fx-tronik/svs-controller/components/DMX.xlsx

Qty | Value | Device | Package | Parts | Description | MF | MPN | link | zamiennik
1 |  | PINHD-1X8/90 | 1X08/90 | JP1 | PIN HEADER | CONNFLY | DS1022-1*20RDF1-1 | https://www.tme.eu/pl/details/zl211-20kg/listwy-i-gniazda-kolkowe/connfly/ds1022-1_20rdf1-1/
3 | 0.1UF | C-EUC0603 | C0603 | C1, C4, C7 | CAPACITOR, European symbol | AVX | 06033C104KAT2A | https://pl.mouser.com/ProductDetail/AVX/06033C104KAT2A?qs=sGAEpiMZZMs0AnBnWHyRQNmRHsAguE21wvjfH6R99Ys%3d | https://pl.mouser.com/ProductDetail/KEMET/C0603C104K4RAC7411
2 | 10UF | C-EUC0805 | C0805 | C3, C6 | CAPACITOR, European symbol | AVX | 08056G106ZAT2A | https://pl.mouser.com/ProductDetail/AVX/08056G106ZAT2A
2 | 10k | R-EU_R0603 | R0603 | R1, R2 | RESISTOR, European symbol | Yageo | RC0603JR-0710KA | https://pl.mouser.com/ProductDetail/Yageo/RC0603JR-0710KA
1 | 120 | R-EU_R0603 | R0603 | R5 | RESISTOR, European symbol | Yageo | RC0603FR-10120RL | https://pl.mouser.com/ProductDetail/Yageo/RC0603FR-10120RL
3 | 1UF | C-EUC0603 | C0603 | C2, C5, C8 | CAPACITOR, European symbol | AVX | 0603YC105KAT4A | https://pl.mouser.com/ProductDetail/AVX/0603YC105KAT4A | https://pl.mouser.com/ProductDetail/AVX/0603ZG105ZAT2A
2 | 560 | R-EU_R0603 | R0603 | R3, R4 | RESISTOR, European symbol | Yageo | RC0603FR-13560RL | https://pl.mouser.com/ProductDetail/Yageo/RC0603FR-13560RL
1 | BAT54C | BAT54C | SOT23 | D1 | Schottky Diodes | ROHM Semiconductor | 755-BAT54AHMFHT116 | https://pl.mouser.com/ProductDetail/ROHM-Semiconductor/BAT54AHMFHT116
1 | MAX14946 | MAX14946 | SOIC16W | U$1 | Isolated 500kbps Half-Duplex | Maxim | 700-MAX14946EWE+ | https://pl.mouser.com/ProductDetail/Maxim-Integrated/MAX14946EWE%2b
1 | NC5FAH | NC5FAH | NC5FAH | X2 | Neutrik Audio Connector XLR SERIES | Neutrik | NC5FAH | https://pl.mouser.com/ProductDetail/Neutrik/NC5FAH
1 | SWS003 | SWS003 | SMS-003 | S1 | SMD Dip Switch 3 pol. | CTS Electronic Components | 774-2193MST | https://pl.mouser.com/ProductDetail/CTS-Electronic-Components/219-3MST
1 | WURTH_TRANSFORMER_750315227 | WURTH_TRANSFORMER_750315227 | WURTH750315227 | U$2 |  | Wurth Electronics | 710-750315227 | https://pl.mouser.com/ProductDetail/Wurth-Electronics/750315227
