fx-tronik/svs-controller/components/MCU.xlsx

Qty | Value | Device | Package | Parts | Description | MF | MPN | link | zamiennik | w innej konfiguracji | komentarz
16 |  | LEDCHIP-LED0603 | CHIP-LED0603 | LED1, LED2, LED3, LED4, LED5, LED6, LED7, LED8, LED12, LED13, LED14, LED15, LED16, LED17, LED18, LED19 | LED | Kingbright | APTD1608LCGCK | https://pl.mouser.com/ProductDetail/Kingbright/APTD1608LCGCK
2 |  | LEDCHIP-LED0603 | CHIP-LED0603 | LED9, LED10 | LED | Kingbright | APTD1608LSURCK | https://pl.mouser.com/ProductDetail/Kingbright/APTD1608LSURCK
1 |  | ML10 | ML10 | SV1 | HARTING | Wurth Electronics | 61201021621 | https://pl.mouser.com/ProductDetail/Wurth-Electronics/61201021621
1 |  | PINHD-1X2 | 1X02 | JP3 | PIN HEADER | NINIGI | ZL2019-40 | nie potrzeba, jest na magazynie
1 |  | PINHD-2X12 | 2X12 | JP2 | PIN HEADER | NINIGI | ZL2019-40 | https://www.tme.eu/pl/details/zl2019-2x20/listwy-i-gniazda-kolkowe/ninigi/zl2019-40/
1 |  | PINHD-2X6 | 2X06 | JP1 | PIN HEADER | NINIGI | ZL2019-40 | JP1 oraz JP2 z jednej złączki
1 |  | STM32F429ZILQFP144 | LQFP144 | IC2 |  | STMicroelectronics | STM32F429ZIT6 | https://pl.mouser.com/ProductDetail/STMicroelectronics/STM32F429ZIT6?qs=sGAEpiMZZMvh0aGzCjJ9puxTF1TQ%2fe28
2 | 0,22uF | C-EUC0603 | C0603 | C48, C51 | CAPACITOR, European symbol | AVX | 0603ZC224KAT9A | https://pl.mouser.com/ProductDetail/AVX/0603ZC224KAT9A
5 | 0R | R-EU_R0603 | R0603 | R41, R42, R43, R44, R45 | RESISTOR, European symbol | Yageo | RC0603JR-070RL | https://pl.mouser.com/ProductDetail/Yageo/RC0603JR-070RL | https://pl.mouser.com/ProductDetail/Yageo/AC0603JR-130RL
20 | 1.2k | R-EU_R0603 | R0603 | R17, R18, R19, R20, R21, R22, R23, R24, R25, R27, R28, R29, R54, R55, R56, R57, R58, R59, R60, R61 | RESISTOR, European symbol | Yageo | RC0603FR-071K2L | https://pl.mouser.com/ProductDetail/Yageo/RC0603FR-071K2L?qs=sGAEpiMZZMu61qfTUdNhG5eFuApKbqVdGHoRw3xWRI8%3d | https://pl.mouser.com/ProductDetail/Yageo/RC0603FR-131K2L?qs=sGAEpiMZZMu61qfTUdNhG6gKAQVNBKOo4NYn0ZHNCDU%3d
12 | 100nF | C-EUC0603 | C0603 | C33, C34, C35, C37, C38, C39, C40, C41, C42, C43, C46, C47 | CAPACITOR, European symbol | AVX | 06033C104KAT2A | https://pl.mouser.com/ProductDetail/AVX/06033C104KAT2A?qs=sGAEpiMZZMs0AnBnWHyRQNmRHsAguE21wvjfH6R99Ys%3d | https://pl.mouser.com/ProductDetail/KEMET/C0603C104K4RAC7411
15 | 100nF | C-EUC0603K | C0603K | C9, C16, C17, C18, C19, C20, C21, C22, C23, C24, C26, C28, C29, C31, C32 | CAPACITOR, European symbol | AVX | 06033C104KAT2A | to samo co wyżej
2 | 10pF | C-EUC0603K | C0603K | C11, C12 | CAPACITOR, European symbol | AVX | 06035A100JAT2A | https://pl.mouser.com/ProductDetail/AVX/06035A100JAT2A | https://pl.mouser.com/ProductDetail/AVX/06035A100K4T4A
1 | 10uF | CPOL-EUSMCA | SMC_A | C36 | POLARIZED CAPACITOR, European symbol | AVX | F931A106MAA | https://pl.mouser.com/ProductDetail/AVX/F931A106MAA?qs=sGAEpiMZZMuEN2agSAc2puC4lhRhLeoldocdITijc4A%3d
2 | 10uF/6,3V | C-EUC1206 | C1206 | C50, C53 | CAPACITOR, European symbol | AVX | 12066G106ZAT4A | https://pl.mouser.com/ProductDetail/AVX/12066G106ZAT4A
2 | 110R | R-EU_R0603 | R0603 | R50, R52 | RESISTOR, European symbol | Yageo | RC0603FR-07110RL | https://pl.mouser.com/ProductDetail/Yageo/RC0603FR-07110RL?qs=sGAEpiMZZMu61qfTUdNhG0fejjHH2KXSKTcPaQ6ifbY%3d
2 | 191k | R-EU_R0603 | R0603 | R111, R115 | RESISTOR, European symbol | Yageo | AC0603FR-07191KL | https://pl.mouser.com/ProductDetail/Yageo/AC0603FR-07191KL
1 | 1K5 | R-EU_R0603 | R0603 | R31 | RESISTOR, European symbol | Yageo | RC0603FR-071K5P | https://pl.mouser.com/ProductDetail/Yageo/RC0603FR-071K5P
2 | 1nF, 2kV | C-EUC1206 | C1206 | C44, C45 | CAPACITOR, European symbol | Vishay | VJ1206Y102MXFAT4X | https://pl.mouser.com/ProductDetail/Vishay-Vitramon/VJ1206Y102MXFAT4X
2 | 1uF | C-EUC0603K | C0603K | C10, C30 | CAPACITOR, European symbol | AVX | 0603YC105KAT4A | https://pl.mouser.com/ProductDetail/AVX/0603YC105KAT4A | https://pl.mouser.com/ProductDetail/AVX/0603ZG105ZAT2A
2 | 1uF/50V | C-EUC1206 | C1206 | C49, C52 | CAPACITOR, European symbol | AVX | 12065C105M4Z2A | https://pl.mouser.com/ProductDetail/AVX/12065C105M4Z2A
8 | 2.2nF | C-EUC0805 | C0805 | C1, C2, C3, C4, C5, C6, C7, C8 | CAPACITOR, European symbol | AVX | 06035C222JAT2A | https://pl.mouser.com/ProductDetail/AVX/06035C222JAT2A
2 | 2.2uF | C-EUC0603K | C0603K | C25, C27 | CAPACITOR, European symbol | AVX | 06036C225KAT2A | https://pl.mouser.com/ProductDetail/AVX/06036C225KAT2A | https://pl.mouser.com/ProductDetail/AVX/06036G225ZAT2A
8 | 2.4k | R-EU_R1206 | R1206 | R9, R10, R11, R12, R13, R14, R15, R16 | RESISTOR, European symbol | Yageo | RC1206JR-072K4L | https://pl.mouser.com/ProductDetail/Yageo/RC1206JR-072K4L
8 | 210R | R-EU_R0603 | R0603 | R87, R88, R89, R90, R95, R96, R97, R98 | RESISTOR, European symbol | Bourns | CR0603-FX-2100ELF | https://pl.mouser.com/ProductDetail/Bourns/CR0603-FX-2100ELF
2 | 220uH | SRR4528A221M | SRR4528A | L2, L3 | SRR4528A | Bourns | SRR4528A-221M | https://pl.mouser.com/ProductDetail/Bourns/SRR4528A-221M
3 | 22k1 | R-EU_R0603 | R0603 | R26, R112, R116 | RESISTOR, European symbol | Yageo | AC0603FR-0722K1L | https://pl.mouser.com/ProductDetail/Yageo/AC0603FR-0722K1L
2 | 22pF | C-EUC0603K | C0603K | C13, C14 | CAPACITOR, European symbol | AVX | 06035A220JAT2A | https://pl.mouser.com/ProductDetail/AVX/06035A220JAT2A | https://pl.mouser.com/ProductDetail/AVX/06033A220JAT2A | https://pl.mouser.com/ProductDetail/AVX/0603YA270KAT2A?qs=sGAEpiMZZMs0AnBnWHyRQKdiqyDPVQdA8KETn2weImg%3d | musi współgrać z Q2 - CRYSTAL został zmieniony, możliwe, że wymagać będzie to także zmiany kondensatorów
2 | 261k | R-EU_R0603 | R0603 | R113, R117 | RESISTOR, European symbol | Bourns | CR0603-FX-2613ELF | https://pl.mouser.com/ProductDetail/Bourns/CR0603-FX-2613ELF
7 | 2K2 | R-EU_R0603 | R0603 | R30, R32, R33, R35, R36, R51, R53 | RESISTOR, European symbol | Yageo | RC0603FR-072K2P | https://pl.mouser.com/ProductDetail/Yageo/RC0603FR-072K2P
8 | 2k7 | R-EU_R0603 | R0603 | R91, R92, R93, R94, R99, R100, R101, R102 | RESISTOR, European symbol | Yageo | RC0603JR-072K7L | https://pl.mouser.com/ProductDetail/Yageo/RC0603JR-072K7L?qs=sGAEpiMZZMu61qfTUdNhG5eFuApKbqVdG3WnDY66KrI%3d
8 | 300R | R-EU_R0603 | R0603 | R79, R80, R81, R82, R103, R104, R105, R106 | RESISTOR, European symbol | Yageo | AC0603FR-07300RL | https://pl.mouser.com/ProductDetail/Yageo/AC0603FR-07300RL
1 | 32.768kHz | CRYSTAL3.5X1.5 | CRYSTAL_3.5X1.5 | Q1 | CRYSTAL | ECS | ECS-.327-9-34QCS-TR | https://pl.mouser.com/ProductDetail/ECS/ECS-327-9-34QCS-TR
17 | 33R | R-EU_R0603 | R0603 | R62, R63, R64, R65, R66, R67, R68, R69, R70, R71, R72, R73, R74, R75, R76, R77, R78 | RESISTOR, European symbol | Yageo | RC0603FR-071K2L | https://pl.mouser.com/ProductDetail/Yageo/RC0603FR-131K2L?qs=sGAEpiMZZMu61qfTUdNhG6gKAQVNBKOo4NYn0ZHNCDU%3d
1 | 4.7uF | C-EUC0603K | C0603K | C15 | CAPACITOR, European symbol | AVX | 0603ZD475KAT2A | https://pl.mouser.com/ProductDetail/AVX/0603ZD475KAT2A | https://pl.mouser.com/ProductDetail/Taiyo-Yuden/JMK107BJ475MA-T
4 | 49.9R | R-EU_R0603 | R0603 | R37, R38, R39, R40 | RESISTOR, European symbol | Bourns | CR0603-FX-49R9GLF | https://pl.mouser.com/ProductDetail/Bourns/CR0603-FX-49R9GLF
2 | 49k9 | R-EU_R0603 | R0603 | R114, R118 | RESISTOR, European symbol | Vishay | CRCW060349K9FKEB | https://pl.mouser.com/ProductDetail/Vishay/CRCW060349K9FKEB?qs=sGAEpiMZZMu61qfTUdNhG2DpbjADlD3GODaSehfwJ2c%3d
1 | 4K87, 1% | R-EU_R0603 | R0603 | R34 | RESISTOR, European symbol | Yageo | AC0603FR-074K87L | https://pl.mouser.com/ProductDetail/Yageo/AC0603FR-074K87L
8 | 523R | R-EU_R0603 | R0603 | R83, R84, R85, R86, R107, R108, R109, R110 | RESISTOR, European symbol | Yageo | RC0603FR-07523RL | https://pl.mouser.com/ProductDetail/Yageo/RC0603FR-07523RL
8 | 6.2k | R-EU_R1206 | R1206 | R1, R2, R3, R4, R5, R6, R7, R8 | RESISTOR, European symbol | Yageo | RC1206JR-076K2L | https://pl.mouser.com/ProductDetail/Yageo/RC1206JR-076K2L
1 | 600R | FB_0603 | L0603 | L1 | FERRITE BEAD | TDK | MMZ1608S601ATD25 | https://pl.mouser.com/ProductDetail/TDK/MMZ1608S601ATD25
4 | 75R | R-EU_R0603 | R0603 | R46, R47, R48, R49 | RESISTOR, European symbol | Yageo | RC0603JR-0775RL | https://pl.mouser.com/ProductDetail/Yageo/RC0603JR-0775RL
1 | APHF1608SEEQBDZGKC | APHF1608SEEQBDZGKC | APHF1608SEEQBDZGKC | LED11 | APHF1608SEEQBDZGKC | Kingbright | APHF1608SEEQBDZGKC | https://pl.mouser.com/ProductDetail/Kingbright/APHF1608SEEQBDZGKC
1 | CFPS-39-CFPS-39 | CFPS-39-CFPS-39 | 3.4X2.7-4-PAD | OS1 | OSCILLATOR WITH OE | IQD | LFSPXO025560 | https://pl.mouser.com/ProductDetail/IQD/LFSPXO025560Reel
1 | CH25-2032LF | CH25-2032LF | CH25-2032LF | G1 | Podstawka - bateria pastylka | G1 | CH25-2032 | https://www.tme.eu/pl/details/ch25-2032/baterie-pojemniki-i-uchwyty/comf/
1 | CRYSTAL_SHIELD | CRYSTAL_SHIELD | CRYSTAL_5X3.2 | Q2 |  | IQD | LFXTAL059158 | https://pl.mouser.com/ProductDetail/IQD/LFXTAL059158Reel | https://pl.mouser.com/ProductDetail/ECS/ECS-80-18-30B-AGN-TR
1 | DP83848 | DP83848 | LQFP48 | IC3 | PHYTER® - Extended Temperature Single Port 10/100 Mb/s Ethernet Physical Layer Transceiver | Texas Instruments | DP83848CVV/NOPB | https://pl.mouser.com/ProductDetail/Texas-Instruments/DP83848CVV-NOPB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
1 | DTSM-6 | DTSM-6 | DTSM-6 | S1 |  | DIPTRONICS | DTSM-63N-V-B | https://pl.mouser.com/ProductDetail/Diptronics/DTSM-63N-V-B
1 | H1102NL | HX1188 | HXXXX | T1 | Transformer- H110X, H1121, HX1188 | PULSE | H1102NL | https://pl.mouser.com/ProductDetail/Pulse-Electronics/H1102NL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
2 | HCPL0531 | HCPL0531 | SOIC08 | OK1, OK2 | HEWLETT PACKARD OPTO COUPLER | Broadcom / Avago | HCPL-0531-500E | https://pl.mouser.com/ProductDetail/Broadcom-Avago/HCPL-0531-500E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
2 | MAX17552 | MAX17552 | TSSOP-10(10UMAX) | IC4, IC5 |  | Maxim | MAX17552AUB+ | https://pl.mouser.com/ProductDetail/Maxim-Integrated/MAX17552AUB%2b
2 | MIC2981/82 | MIC2981/82 | SOP18 | Q3, Q4 |  | Microchip | MIC2981/82YWM | https://pl.mouser.com/ProductDetail/Microchip-Technology-Micrel/MIC2981-82YWM
11 | MKDSN1,5/2-5,08 | MKDSN1,5/2-5,08 | MKDSN1,5/2-5,08 | X1, X2, X3, X4, X5, X6, X7, X8, X9, X10, X11 | MKDSN 1,5/ 2-5,08 Printklemme | NINIGI | TB-5.08-P-2P/BL | https://www.tme.eu/pl/details/tb-5.08-p-2p_bl/listwy-zaciskowe-do-druku/ninigi/
1 | RJHSE-5381 | RJHSE-5381 | MAGJACK-19938 | J1 | RJ-45 with LEDs | AMPHENOL | RJHSE-5381 | https://www.tme.eu/pl/details/rj45geled-ape/zlacza-rj/amphenol/rjhse-5381/
1 | SI8382P-IU | SI838X | QSOP-20 | IC1 |  | Silicon Labs | SI8382P-IU | https://pl.mouser.com/ProductDetail/Silicon-Labs/SI8382P-IU
1 | TLP291-4 | TLP291-4 | SO16 | OK3 |  | Toshiba | TLP291-4(GB,E) | https://pl.mouser.com/ProductDetail/Toshiba/TLP291-4GBE?qs=sGAEpiMZZMteimceiIVCB3qZhEwbmgeEcs1gp1z2mmM%3d
1 | USBLC6-4SC6 | USBLC6-4SC6 | SOT23-6 | D1 |  | ST-MICROELECTRONICS | USBLC6-4SC6 | https://pl.mouser.com/ProductDetail/STMicroelectronics/USBLC6-4SC6
