fx-tronik/svs-controller/components/PWR.xlsx

Qty | Value | Device | Package | Parts | Description | MF | MPN | link | zamiennik
1 |  | PINHD-1X8/90 | 1X08/90 | JP1 | PIN HEADER | CONNFLY | DS1024-1*8R0 | https://www.tme.eu/pl/details/zl263-8sg/listwy-i-gniazda-kolkowe/connfly/ds1024-1_8r0/
1 |  | PINHD-2X12 | 2X12 | JP3 | PIN HEADER | CONNFLY | DS1023-2*12S21 | https://www.tme.eu/pl/details/zl262-24dg/listwy-i-gniazda-kolkowe/connfly/ds1023-2_12s21/
1 |  | PINHD-2X16/90 | 2X16/90 | JP4 | PIN HEADER | CONNFLY | DS1024-2*16R0 | https://www.tme.eu/pl/details/zl263-32dg/listwy-i-gniazda-kolkowe/connfly/ds1024-2_16r0/
1 |  | PINHD-2X6 | 2X06 | JP2 | PIN HEADER | CONNFLY | DS1023-2*6S21 | https://www.tme.eu/pl/details/zl262-12dg/listwy-i-gniazda-kolkowe/connfly/ds1023-2_6s21/
1 |  | SCHOTTKY-DIODESMD | SMB | D2 | Schottky Diode | ON Semiconductor | SS26T3G | https://pl.mouser.com/ProductDetail/ON-Semiconductor/SS26T3G
1 | 100uF | CPOL-EUSMCC | SMC_C | C9 | POLARIZED CAPACITOR, European symbol | AVX | TAJC107K010TNJ | https://pl.mouser.com/ProductDetail/AVX/TAJC107K010TNJ
4 | 100uF | CPOL-USTT5D10 | TT5D10 | C1, C2, C6, C7 | POLARIZED CAPACITOR, American symbol | Nichicon | UPJ1H101MPD6 | https://pl.mouser.com/ProductDetail/Nichicon/UPJ1H101MPD6
1 | 10nF | C-EUC0603 | C0603 | C8 | CAPACITOR, European symbol | AVX | 06035C103KAT2A | https://pl.mouser.com/ProductDetail/AVX/06035C103KAT2A | https://pl.mouser.com/ProductDetail/KEMET/C0603C103J5RAC7411?qs=sGAEpiMZZMs0AnBnWHyRQDE3Md0GeJar0Ly0tDhsHg8%3d
1 | 220nH | SRP7028A-R33M | 7.3X6.3 | L1 | SRP7028A-R33M | Bourns | SRP7028A-R22Y | https://pl.mouser.com/ProductDetail/Bourns/SRP7028A-R22Y
3 | 4.7uF | C-EUC0805 | C0805 | C3, C4, C5 | CAPACITOR, European symbol | Murata Electronics | GRM21BR61H475ME51L | https://pl.mouser.com/ProductDetail/Murata-Electronics/GRM21BR61H475ME51L
1 | 47uH | SRR1280-101M | 12.5X12.5 | L2 | SRR1280-101M | Bourns | SRR1280-470M | https://pl.mouser.com/ProductDetail/Bourns/SRR1280-470M
4 | 500mA | TR5 | TR5 | F1, F2, F3, F4 | FUSE | Littelfuse | 56000001009 | https://pl.mouser.com/ProductDetail/Littelfuse/56000001009
1 | LM2675M | LM2675M | SO08 | IC1 | National Semiconductor 1.0A Simple Switcher"(c)" | Texas Instruments | LM2675MX-3.3/NOPB | https://pl.mouser.com/ProductDetail/Texas-Instruments/LM2675MX-33-NOPB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
1 | MSTBA2 | MSTBA2 | MSTBA2 | X1 | PHOENIX | DEGSON ELECTRONICS | 2EDGRC-5.08-02P-14-00A(H) | https://www.tme.eu/pl/details/2edgrc5.08-2p14/listwy-zaciskowe-rozlaczalne/degson-electronics/2edgrc-508-02p-14-00ah/
1 | P6SMB20A | P6SMB20A | SMB_A | D1 | P6SMBxxA Series of unidirectional Transient Voltage Suppressor Diodes | Littelfuse | TPSMB24A-VR | https://pl.mouser.com/ProductDetail/Littelfuse/TPSMB24A-VR | https://www.tme.eu/pl/details/p6smb27a/diody-transil-smd-jednokierunkowe/taiwan-semiconductor/p6smb27a-r4/
