fx-tronik/svs-controller/eagle/PWR.brd

## EAGLE design eagle/PWR.brd (2022-07-01)

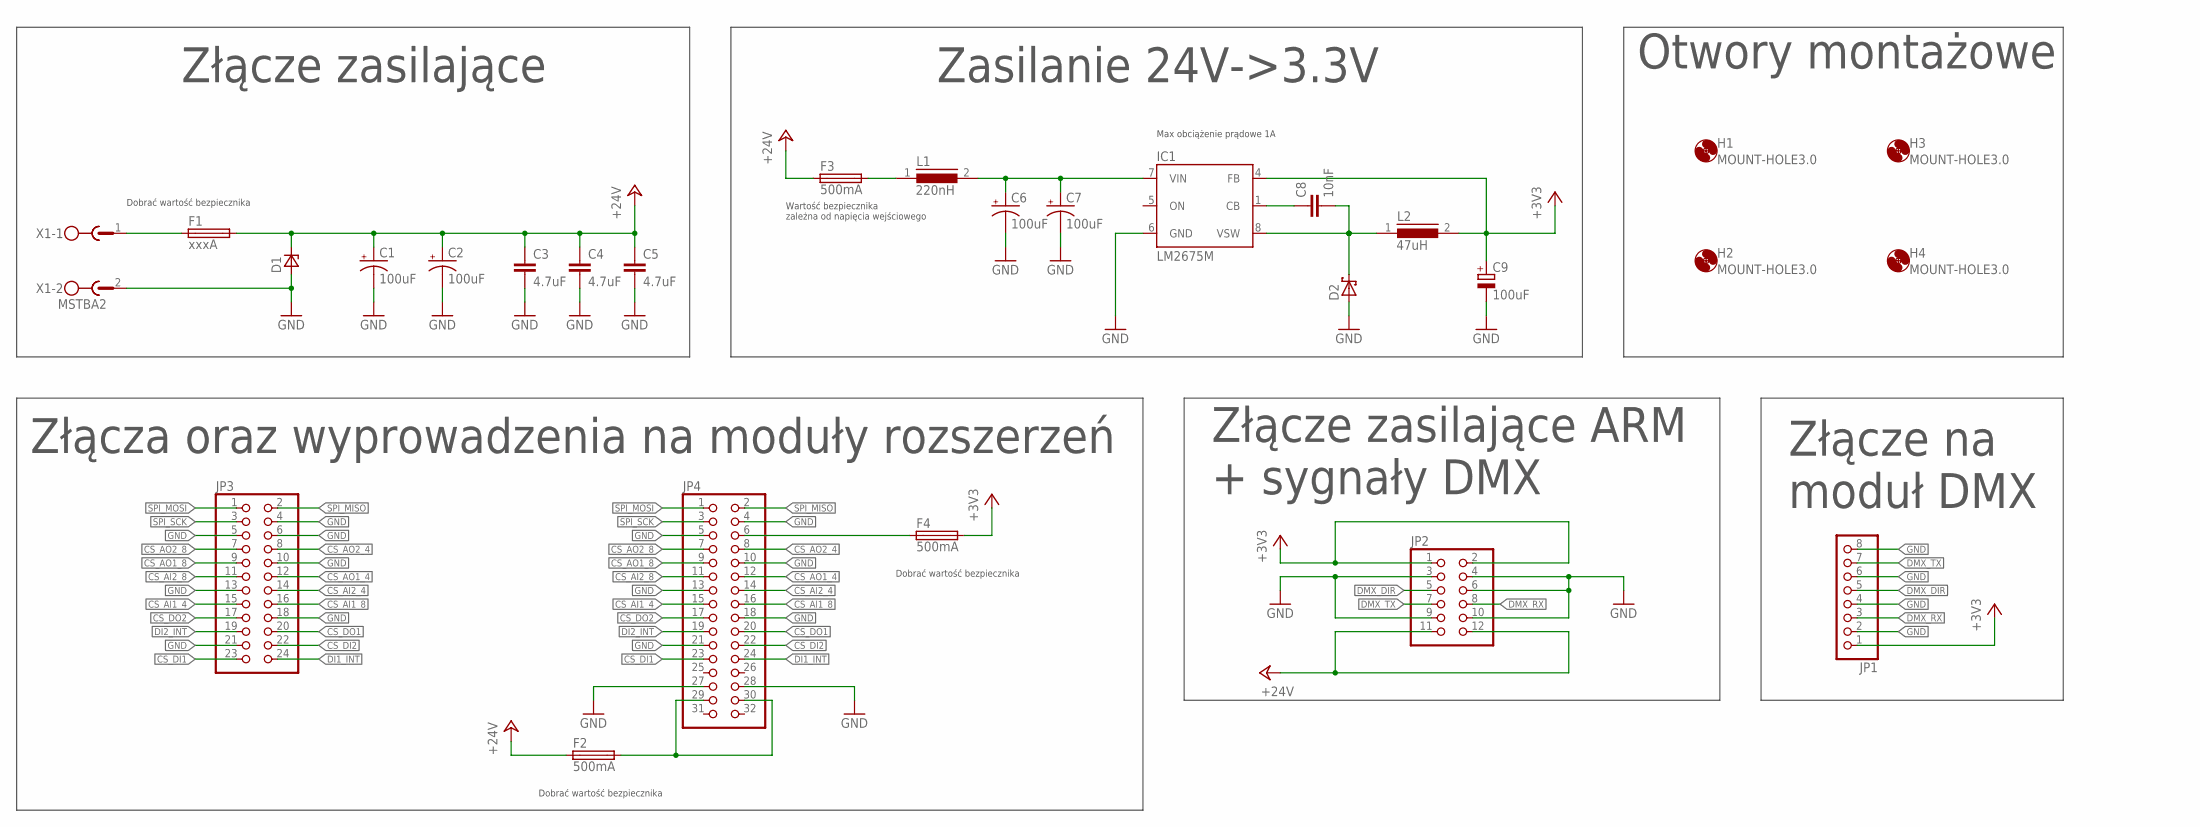
[picture p1: schematic PWR.sch]

Parts:
C1, C2, C6, C7: 100uF; TT5D10; MPN UPJ1H101MPD6
C3, C4, C5: 4.7uF; C0805; MPN GRM21BR61H475ME51L
C8: 10nF; C0603; MPN 06035C103KAT2A
C9: 100uF; SMC_C; MPN TAJC107K010TNJ
D1: P6SMB20A; SMB_A; MPN TPSMB24A-VR
D2: SCHOTTKY-DIODESMD; SMB; MPN SS26T3G
F1: xxxA; TR5; MPN 56000001009
F2, F3, F4: 500mA; TR5; MPN 56000001009
H1, H2, H3, H4: MOUNT-HOLE3.0; 3,0
IC1: LM2675M; SO08; MPN LM2675MX-3.3/NOPB
JP1: PINHD-1X8/90; 1X08/90; MPN DS1024-1*8R0
JP2: PINHD-2X6; 2X06; MPN DS1023-2*6S21
JP3: PINHD-2X12; 2X12; MPN DS1023-2*12S21
JP4: PINHD-2X16/90; 2X16/90; MPN DS1024-2*16R0
L1: 220nH; 7.3X6.3; MPN SRP7028A-R22Y
L2: 47uH; 12.5X12.5; MPN SRR1280-470M
X1: MSTBA2; MPN 2EDGRC-5.08-02P-14-00A(H)

Connections:
+3V3: C9.+, F4.2, IC1.4 (FB), JP1.1, JP2.1, JP2.2, L2.2
+24V: C1.+, C2.+, C3.1, C4.1, C5.1, D1.C, F1.2, F2.1, F3.1, JP2.11, JP2.12
CS_AI1_4: JP3.15, JP4.15
CS_AI1_8: JP3.16, JP4.16
CS_AI2_4: JP3.14, JP4.14
CS_AI2_8: JP3.11, JP4.11
CS_AO1_4: JP3.12, JP4.12
CS_AO1_8: JP3.9, JP4.9
CS_AO2_4: JP3.8, JP4.8
CS_AO2_8: JP3.7, JP4.7
CS_DI1: JP3.23, JP4.23
CS_DI2: JP3.22, JP4.22
CS_DO1: JP3.20, JP4.20
CS_DO2: JP3.17, JP4.17
DI1_INT: JP3.24, JP4.24
DI2_INT: JP3.19, JP4.19
DMX_DIR: JP1.5, JP2.5
DMX_RX: JP1.3, JP2.8
DMX_TX: JP1.7, JP2.7
GND: C1.-, C2.-, C3.2, C4.2, C5.2, C6.-, C7.-, C9.-, D1.A, D2.A, IC1.6 (GND), JP1.2, JP1.4, JP1.6, JP1.8, JP2.3, JP2.4, JP2.6, JP2.9, JP2.10, JP3.4, JP3.5, JP3.6, JP3.10, JP3.13, JP3.18, JP3.21, JP4.4, JP4.5, JP4.10, JP4.13, JP4.18, JP4.21, JP4.27, JP4.28, X1.2
unnamed: F1.1, X1.1
unnamed: F4.1, JP4.6
unnamed: F2.2, JP4.29, JP4.30
unnamed: F3.2, L1.1
unnamed: C8.1, IC1.1 (CB)
SPI_MISO: JP3.2, JP4.2
SPI_MOSI: JP3.1, JP4.1
SPI_SCK: JP3.3, JP4.3
VIN: C6.+, C7.+, IC1.7 (VIN), L1.2
VSW: C8.2, D2.C, IC1.8 (VSW), L2.1

Notes on the sheet:
Dobrać wartość bezpiecznika
Max obciążenie prądowe 1A
Wartość bezpiecznika zależna od napięcia wejściowego
Zasilanie 24V->3.3V
Złącze zasilające
Złącze na moduł DMX
Złącze zasilające ARM + sygnały DMX
Otwory montażowe
Złącza oraz wyprowadzenia na moduły rozszerzeń

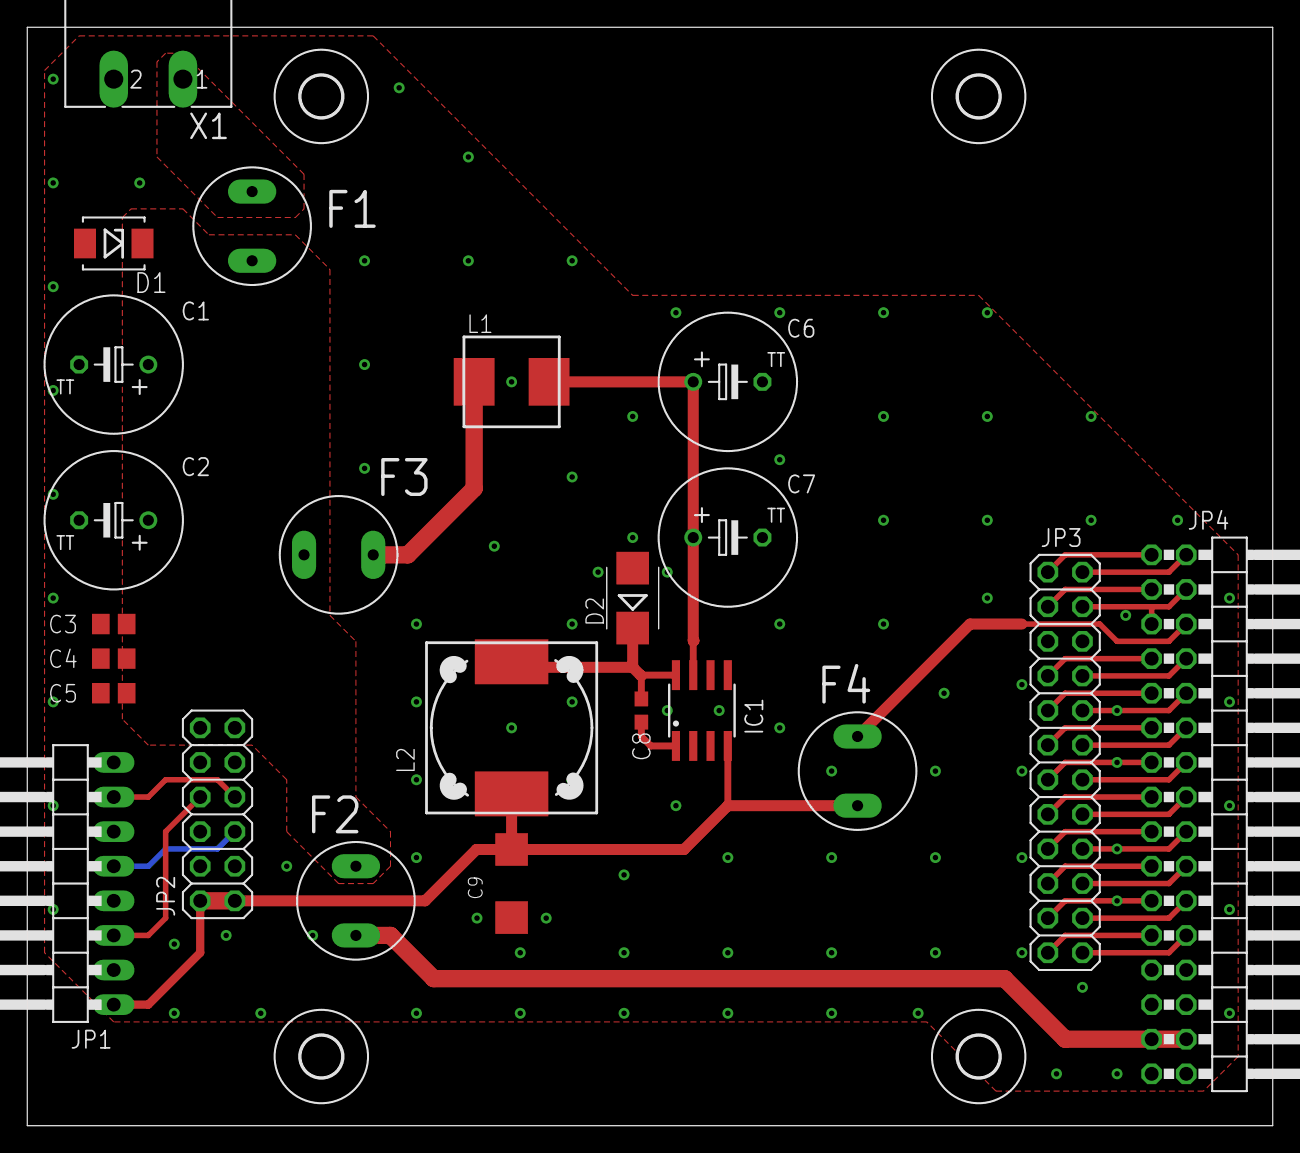
[picture p2: board PWR.brd from above]

Board: 2 copper layers, 91.4 x 80.6 mm, 27 parts (0 on the bottom side), 30 nets.
