fx-tronik/svs-controller/eagle/DMX module.brd

## EAGLE design eagle/DMX module.brd (2022-07-01)

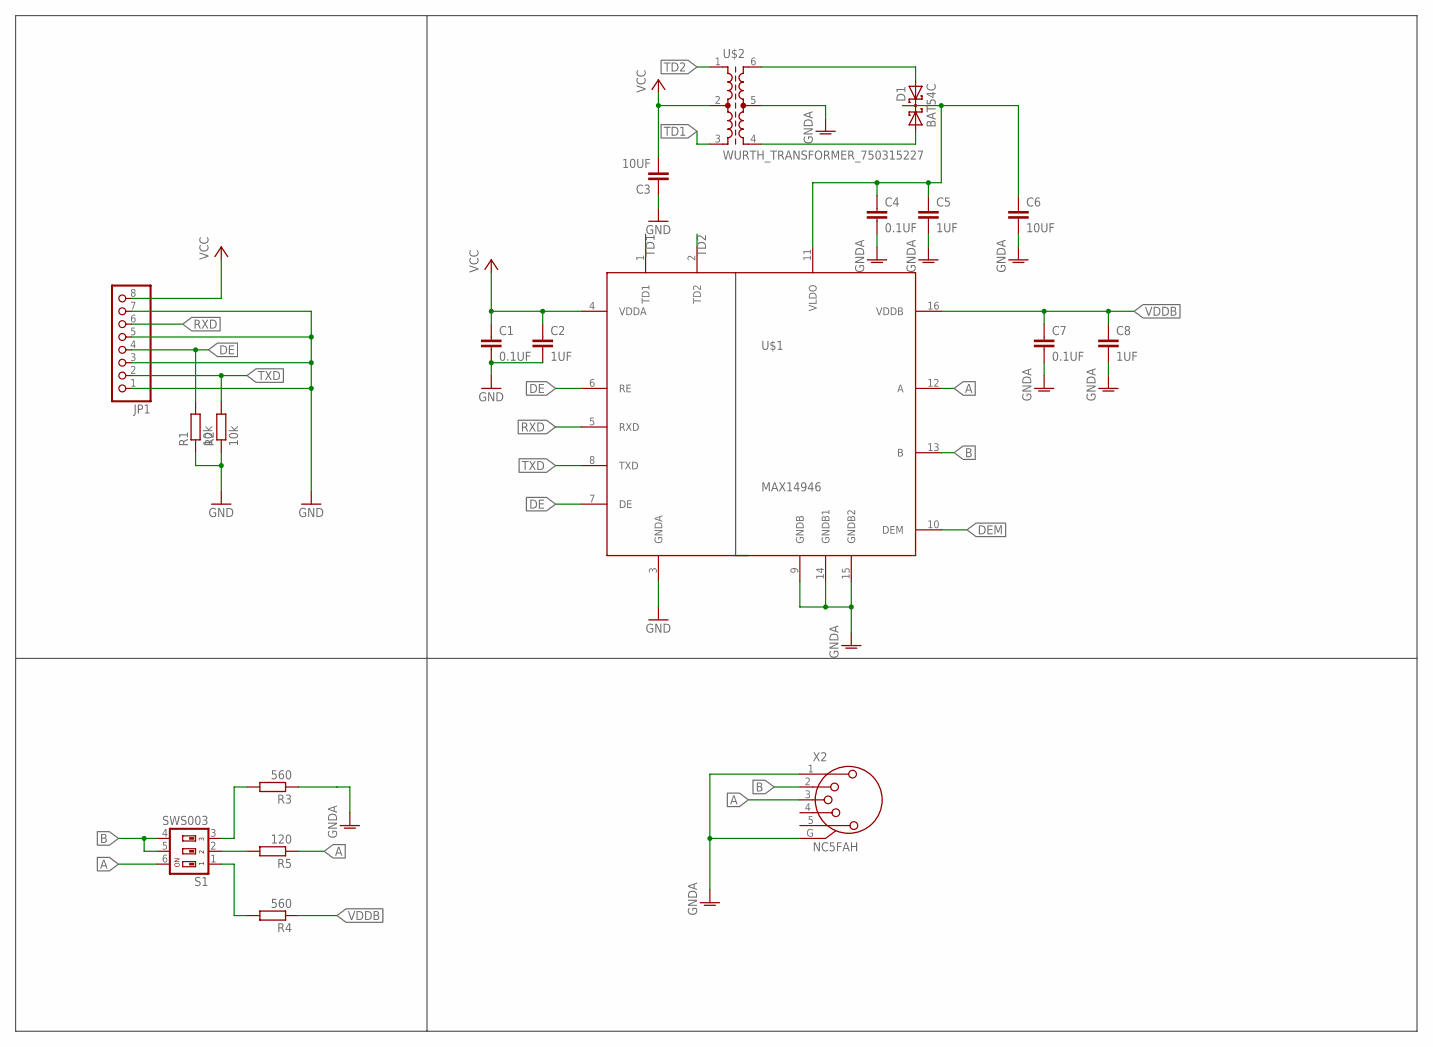
[picture p3: schematic DMX module.sch]

Parts:
C1, C4, C7: 0.1UF; C0603; MPN 06033C104KAT2A
C2, C5, C8: 1UF; C0603; MPN 0603YC105KAT4A
C3, C6: 10UF; C0805; MPN 08056G106ZAT2A
D1: BAT54C; SOT23; MPN 755-BAT54AHMFHT116
JP1: PINHD-1X8/90; 1X08/90; MPN DS1022-1*20RDF1-1
R1, R2: 10k; R0603; MPN RC0603JR-0710KA
R3, R4: 560; R0603; MPN RC0603FR-13560RL
R5: 120; R0603; MPN RC0603FR-10120RL
S1: SWS003; SMS-003; MPN 774-2193MST
U$1: MAX14946; SOIC16W; MPN 700-MAX14946EWE+
U$2: WURTH_TRANSFORMER_750315227; WURTH750315227; MPN 710-750315227
X2: NC5FAH

Connections:
A: R5.1, S1.6, U$1.12 (A), X2.3
B: S1.4, S1.5, U$1.13 (B), X2.2
DE: JP1.4, R1.2, U$1.6 (RE), U$1.7 (DE)
DEM: U$1.10 (DEM)
GND: C1.2, C2.2, C3.1, JP1.1, JP1.3, JP1.5, JP1.7, R1.1, R2.1, U$1.3 (GNDA)
GNDA: C4.2, C5.2, C6.2, C7.2, C8.2, R3.1, U$1.9 (GNDB), U$1.14 (GNDB1), U$1.15 (GNDB2), U$2.5, X2.1, X2.G
unnamed: R5.2, S1.2
unnamed: R4.2, S1.1
unnamed: D1.1 (A1), U$2.4
unnamed: D1.2 (A2), U$2.6
unnamed: C4.1, C5.1, C6.1, D1.3 (CC), U$1.11 (VLDO)
unnamed: R3.2, S1.3
RXD: JP1.6, U$1.5 (RXD)
TD1: U$1.1 (TD1), U$2.3
TD2: U$1.2 (TD2), U$2.1
TXD: JP1.2, R2.2, U$1.8 (TXD)
VCC: C1.1, C2.1, C3.2, JP1.8, U$1.4 (VDDA), U$2.2
VDDB: C7.1, C8.1, R4.1, U$1.16 (VDDB)

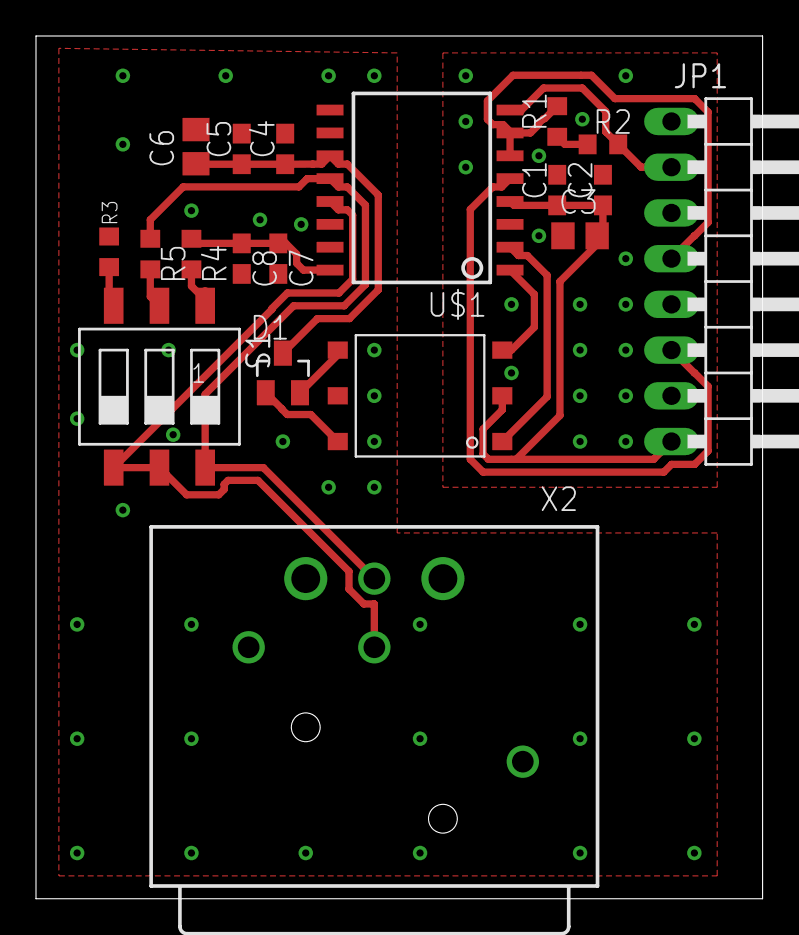
[picture p4: board DMX module.brd from above]

Board: 2 copper layers, 40.4 x 47.9 mm, 19 parts (0 on the bottom side), 17 nets.
