fx-tronik/svs-controller/eagle/SVS.brd

## EAGLE design eagle/SVS.brd (2022-07-01)

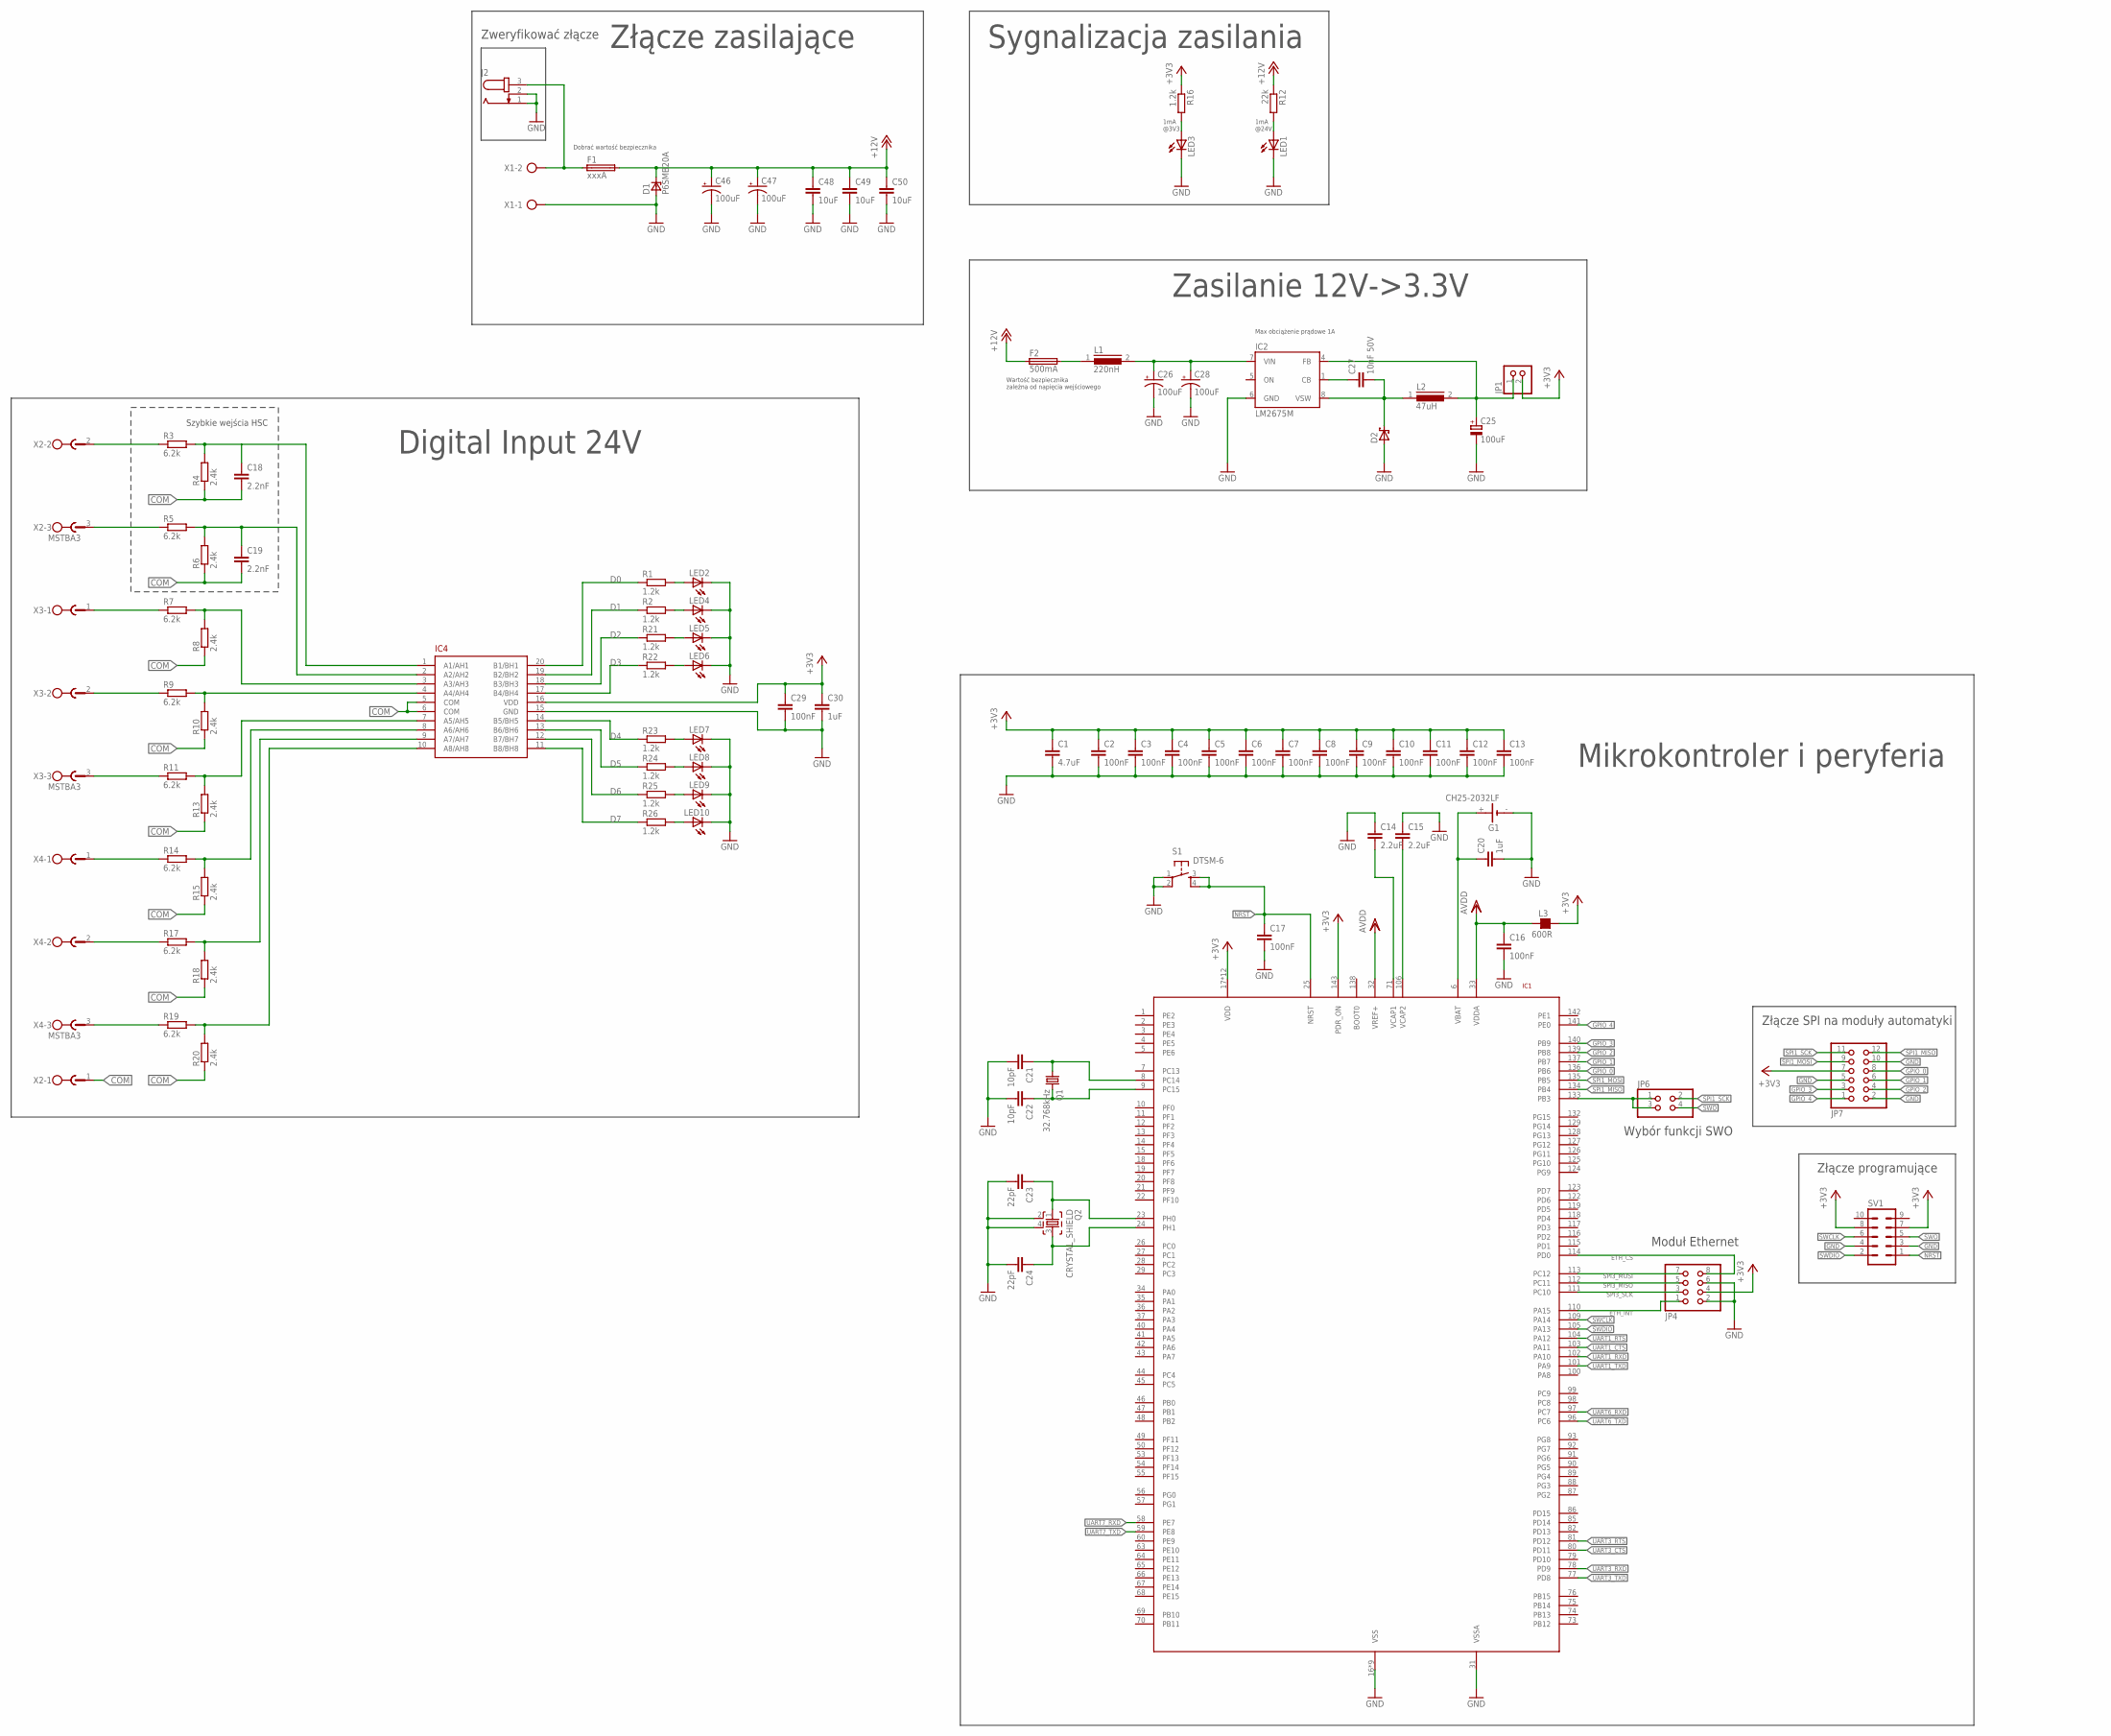
[picture p5: schematic SVS.sch]

Parts:
C1: 4.7uF; C0603K; MPN 0603ZD475KAT2A
C2, C3, C4, C5, C6, C7, C8, C9, C10, C11, C12, C13, C16, C17, C29: 100nF; C0603K; MPN 06033C104KAT2A
C14, C15: 2.2uF; C0603K; MPN 06036C225KAT2A
C18, C19: 2.2nF; C0805; MPN 06035C222JAT2A
C20, C30: 1uF; C0603K; MPN 0603YC105KAT4A
C21, C22: 10pF; C0603K; MPN 06035A100JAT2A
C23, C24: 22pF; C0603K; MPN 06035A220JAT2A
C25: 100uF; SMC_C; MPN TAJC107K010TNJ
C26, C28, C46, C47: 100uF; UD-8X10_NICHICON; MPN UCD1H101MNL1GS
C27: 10nF 50V; C0603; MPN 06035C103KAT2A
C48, C49, C50: 10uF; C0805; MPN GRM21BR6YA106KE43L
D1: P6SMB20A; SMB_A; MPN TPSMB24A-VR
D2: SCHOTTKY-DIODESMD; SMB; MPN SS26T3G
F1: xxxA; TR5
F2: 500mA; TR5
G1: CH25-2032LF; MPN CH25-2032
IC1: STM32F429ZILQFP144; LQFP144; MPN STM32F429ZIT6
IC2: LM2675M; SO08; MPN LM2675MX-3.3/NOPB
IC4: SI838X; QSOP-20; MPN SI8382P-IU
J2: JACK-PLUG1; SPC4078
JP1: PINHD-1X2; 1X02
JP4: PINHD-2X4; 2X04
JP6: PINHD-2X2; 2X02
JP7: PINHD-2X6/90; 2X06/90
L1: 220nH; 7.3X6.3; MPN SRP7028A-R22Y
L2: 47uH; 12.5X12.5; MPN SRR1280-470M
L3: 600R; L0603; MPN MMZ1608S601ATD25
LED1, LED3: LEDCHIP-LED0603; CHIP-LED0603; MPN APTD1608LSURCK
LED2, LED4, LED5, LED6, LED7, LED8, LED9, LED10: LEDCHIP-LED0603; CHIP-LED0603; MPN APTD1608LCGCK
Q1: 32.768kHz; CRYSTAL_3.5X1.5; MPN ECS-.327-9-34QCS-TR
Q2: CRYSTAL_SHIELD; CRYSTAL_5X3.2; MPN LFXTAL059158
R1, R2, R16, R21, R22, R23, R24, R25, R26: 1.2k; R0603; MPN RC0603FR-071K2L
R3, R5, R7, R9, R11, R14, R17, R19: 6.2k; R1206; MPN RC1206JR-076K2L
R4, R6, R8, R10, R13, R15, R18, R20: 2.4k; R1206; MPN RC1206JR-072K4L
R12: 22k; R0603; MPN RC0603FR-0722KL
S1: DTSM-6; MPN DTSM-63N-V-B
SV1: ML10
X1: AK300/2
X2, X3, X4: MSTBA3

Connections:
+3V3: C1.1, C2.1, C3.1, C4.1, C5.1, C6.1, C7.1, C8.1, C9.1, C10.1, C11.1, C12.1, C13.1, C29.1, C30.1, IC1.17 (VDD), IC1.30 (VDD), IC1.39 (VDD), IC1.52 (VDD), IC1.62 (VDD), IC1.72 (VDD), IC1.84 (VDD), IC1.95 (VDD), IC1.108 (VDD), IC1.121 (VDD), IC1.131 (VDD), IC1.143 (PDR_ON), IC1.144 (VDD), IC4.16 (VDD), JP1.2, JP4.4, JP7.7, L3.2, R16.1, SV1.7, SV1.8
+12V: C46.+, C47.+, C48.1, C49.1, C50.1, D1.C, F1.2, F2.1, R12.1
AVDD: IC1.32 (VREF+)
COM: C18.2, C19.2, IC4.5 (COM), IC4.6 (COM), R4.1, R6.1, R8.1, R10.1, R13.1, R15.1, R18.1, R20.1, X2.1
D0: IC4.20 (B1/BH1), R1.1
D1: IC4.19 (B2/BH2), R2.1
D2: IC4.18 (B3/BH3), R21.1
D3: IC4.17 (B4/BH4), R22.1
D4: IC4.14 (B5/BH5), R23.1
D5: IC4.13 (B6/BH6), R24.1
D6: IC4.12 (B7/BH7), R25.1
D7: IC4.11 (B8/BH8), R26.1
ETH_CS: IC1.114 (PD0), JP4.8
ETH_INT: IC1.110 (PA15), JP4.1
GND: C1.2, C2.2, C3.2, C4.2, C5.2, C6.2, C7.2, C8.2, C9.2, C10.2, C11.2, C12.2, C13.2, C14.1, C15.1, C16.2, C17.2, C20.2, C21.2, C22.2, C23.2, C24.2, C25.-, C26.-, C28.-, C29.2, C30.2, C46.-, C47.-, C48.2, C49.2, C50.2, D1.A, D2.A, G1.-, IC1.16 (VSS), IC1.31 (VSSA), IC1.38 (VSS), IC1.51 (VSS), IC1.61 (VSS), IC1.83 (VSS), IC1.94 (VSS), IC1.107 (VSS), IC1.120 (VSS), IC1.130 (VSS), IC2.6 (GND), IC4.15 (GND), J2.1, J2.2, JP4.2, JP4.6, JP7.2, JP7.5, JP7.10, LED1.C, LED2.C, LED3.C, LED4.C, LED5.C, LED6.C, LED7.C, LED8.C, LED9.C, LED10.C, Q2.2, Q2.4, S1.1, S1.2, SV1.3, SV1.4, X1.1
GPIO_0: IC1.136 (PB6), JP7.8
GPIO_1: IC1.137 (PB7), JP7.6
GPIO_2: IC1.139 (PB8), JP7.4
GPIO_3: IC1.140 (PB9), JP7.3
GPIO_4: IC1.141 (PE0), JP7.1
unnamed: F1.1, J2.3, X1.2
unnamed: C14.2, IC1.71 (VCAP1)
unnamed: C15.2, IC1.106 (VCAP2)
unnamed: C21.1, IC1.8 (PC14), Q1.1
unnamed: C22.1, IC1.9 (PC15), Q1.2
unnamed: IC1.133 (PB3), JP6.1, JP6.3
unnamed: C23.1, IC1.23 (PH0), Q2.1
unnamed: C24.1, IC1.24 (PH1), Q2.3
unnamed: C18.1, IC4.1 (A1/AH1), R3.2, R4.2
unnamed: F2.2, L1.1
unnamed: LED2.A, R1.2
unnamed: C19.1, IC4.2 (A2/AH2), R5.2, R6.2
unnamed: LED4.A, R2.2
unnamed: LED5.A, R21.2
unnamed: R3.1, X2.2
unnamed: C27.1, IC2.1 (CB)
unnamed: LED6.A, R22.2
unnamed: R5.1, X2.3
unnamed: IC4.3 (A3/AH3), R7.2, R8.2
unnamed: R7.1, X3.1
unnamed: IC4.4 (A4/AH4), R9.2, R10.2
unnamed: R9.1, X3.2
unnamed: IC4.7 (A5/AH5), R11.2, R13.2
unnamed: R11.1, X3.3
unnamed: IC4.8 (A6/AH6), R14.2, R15.2
unnamed: R14.1, X4.1
unnamed: IC4.9 (A7/AH7), R17.2, R18.2
unnamed: R17.1, X4.2
unnamed: IC4.10 (A8/AH8), R19.2, R20.2
unnamed: R19.1, X4.3
unnamed: LED1.A, R12.2
unnamed: LED7.A, R23.2
unnamed: LED8.A, R24.2
unnamed: LED9.A, R25.2
unnamed: LED10.A, R26.2
unnamed: C25.+, IC2.4 (FB), JP1.1, L2.2
unnamed: LED3.A, R16.2
NRST: C17.1, IC1.25 (NRST), S1.3, S1.4, SV1.1
SPI1_MISO: IC1.134 (PB4), JP7.12
SPI1_MOSI: IC1.135 (PB5), JP7.9
SPI1_SCK: JP6.2, JP7.11
SPI3_MISO: IC1.112 (PC11), JP4.5
SPI3_MOSI: IC1.113 (PC12), JP4.7
SPI3_SCK: IC1.111 (PC10), JP4.3
SWCLK: IC1.109 (PA14), SV1.6
SWDIO: IC1.105 (PA13), SV1.2
SWO: JP6.4, SV1.5
UART1_CTS: IC1.103 (PA11)
UART1_RTS: IC1.104 (PA12)
UART1_RXD: IC1.102 (PA10)
UART1_TXD: IC1.101 (PA9)
UART3_CTS: IC1.80 (PD11)
UART3_RTS: IC1.81 (PD12)
UART3_RXD: IC1.78 (PD9)
UART3_TXD: IC1.77 (PD8)
UART6_RXD: IC1.97 (PC7)
UART6_TXD: IC1.96 (PC6)
UART7_RXD: IC1.58 (PE7)
UART7_TXD: IC1.59 (PE8)
VBAT: C20.1, G1.+, IC1.6 (VBAT)
VDD: C16.1, IC1.33 (VDDA), L3.1
VIN: C26.+, C28.+, IC2.7 (VIN), L1.2
VSW: C27.2, D2.C, IC2.8 (VSW), L2.1

Notes on the sheet:
Dobrać wartość bezpiecznika
Max obciążenie prądowe 1A
Wartość bezpiecznika zależna od napięcia wejściowego
Zasilanie 12V->3.3V
Mikrokontroler i peryferia
Sygnalizacja zasilania
Zweryfikować złącze
Złącze zasilające
1mA @3V3
Moduł Ethernet
Złącze programujące
Złącze SPI na moduły automatyki
Wybór funkcji SWO
Digital Input 24V
Szybkie wejścia HSC
1mA @24V

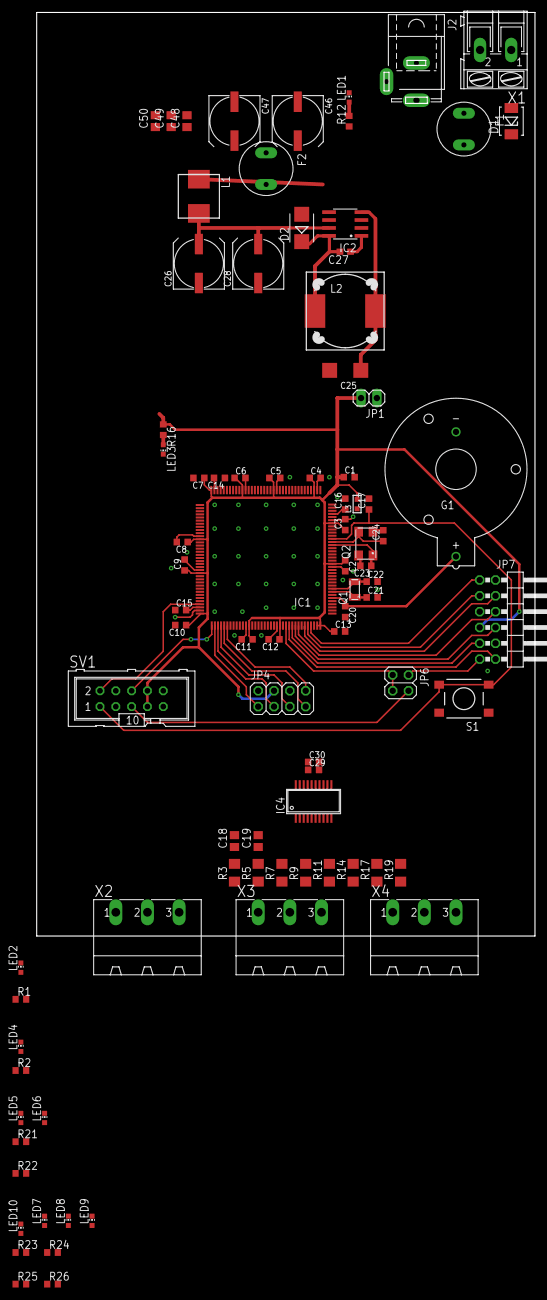
[picture p6: board SVS.brd from above]

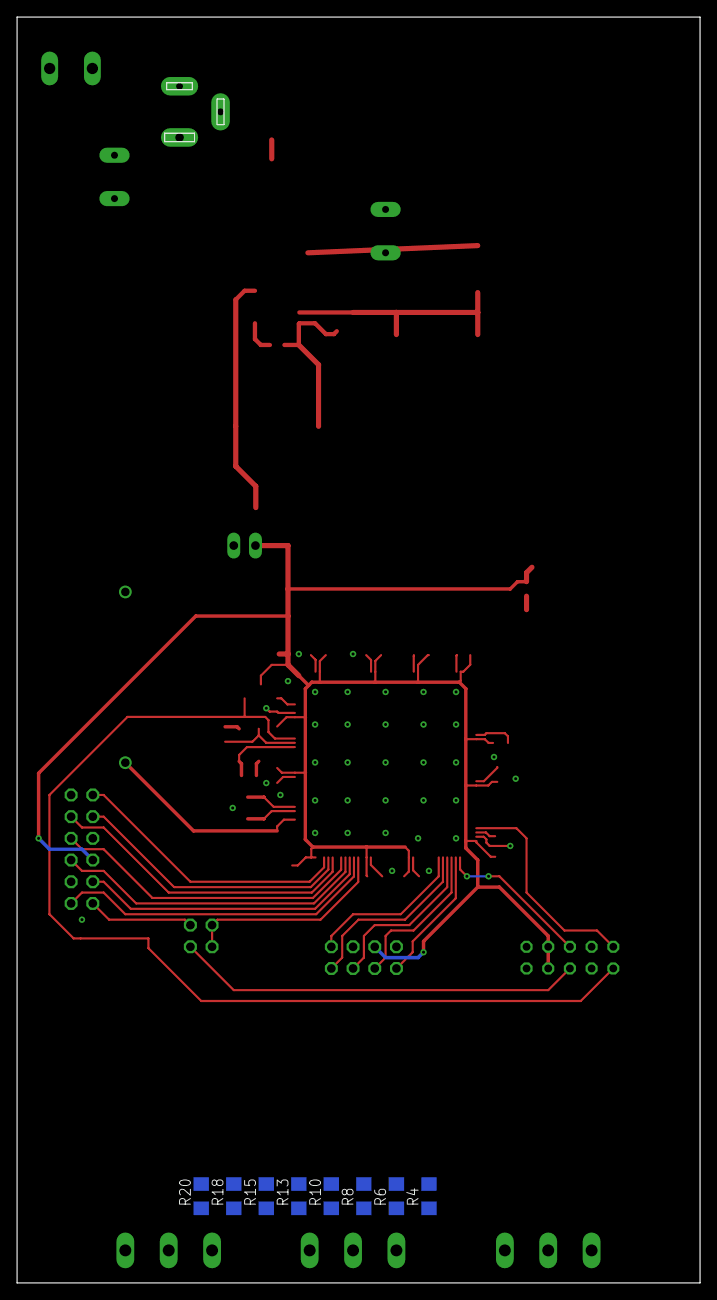
[picture p7: board SVS.brd from below]

Board: 2 copper layers, 80.0 x 148.3 mm, 95 parts (8 on the bottom side), 70 nets.
