fx-tronik/svs-controller/eagle/MCU.brd

## EAGLE design eagle/MCU.brd (2022-07-01)

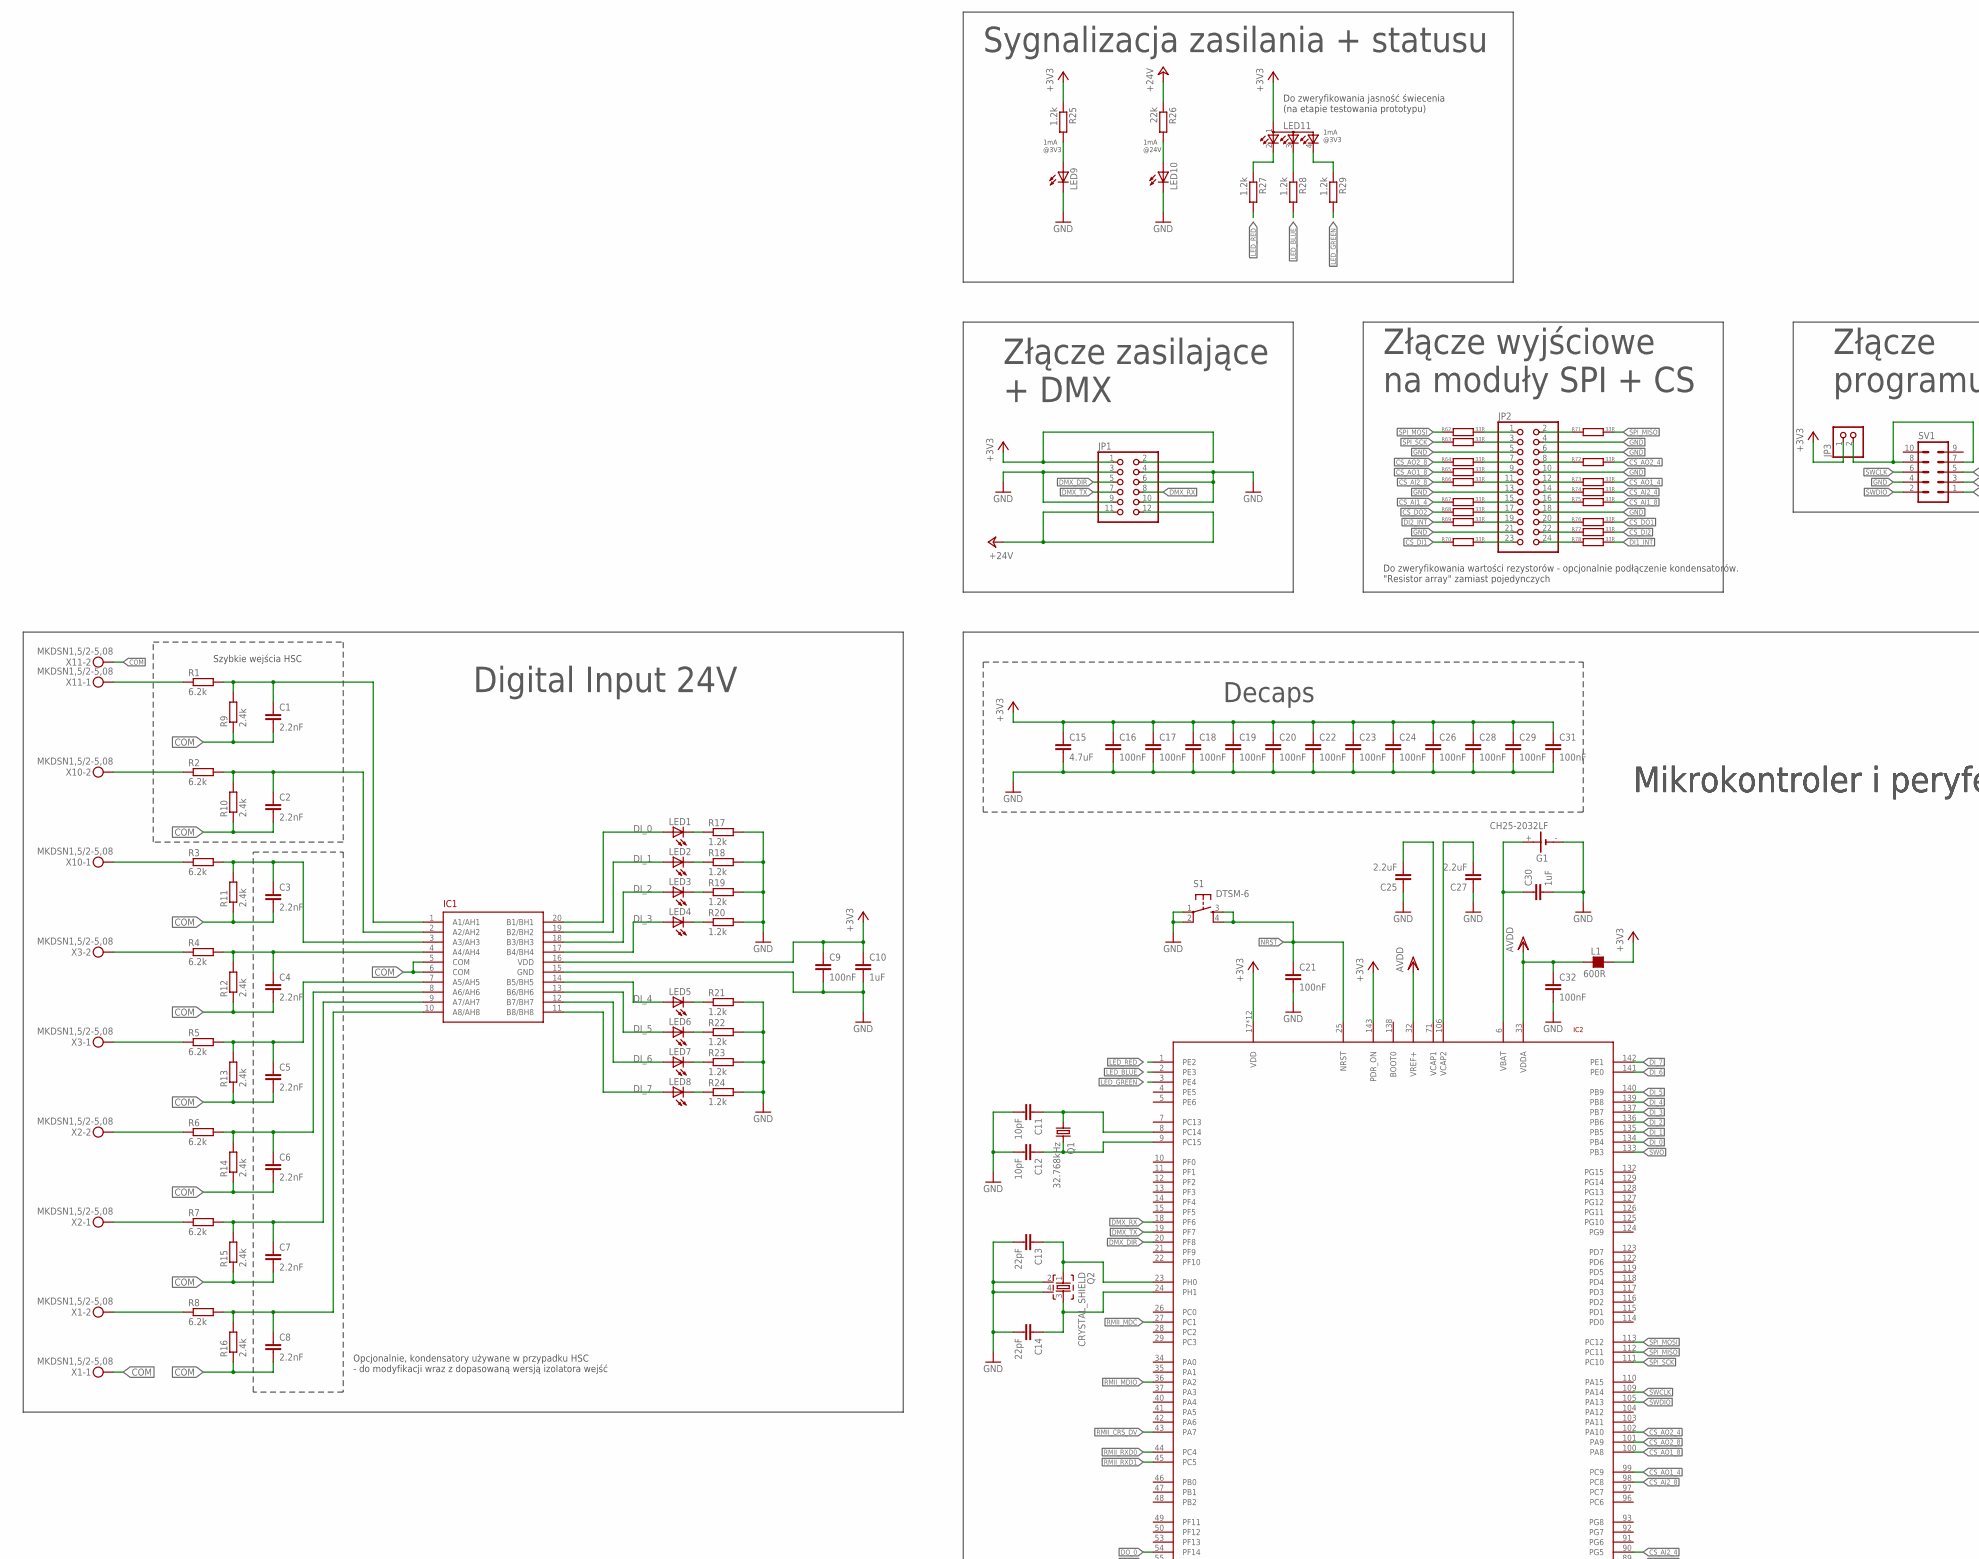
[picture p8: schematic MCU.sch, part in row 1, column 1]

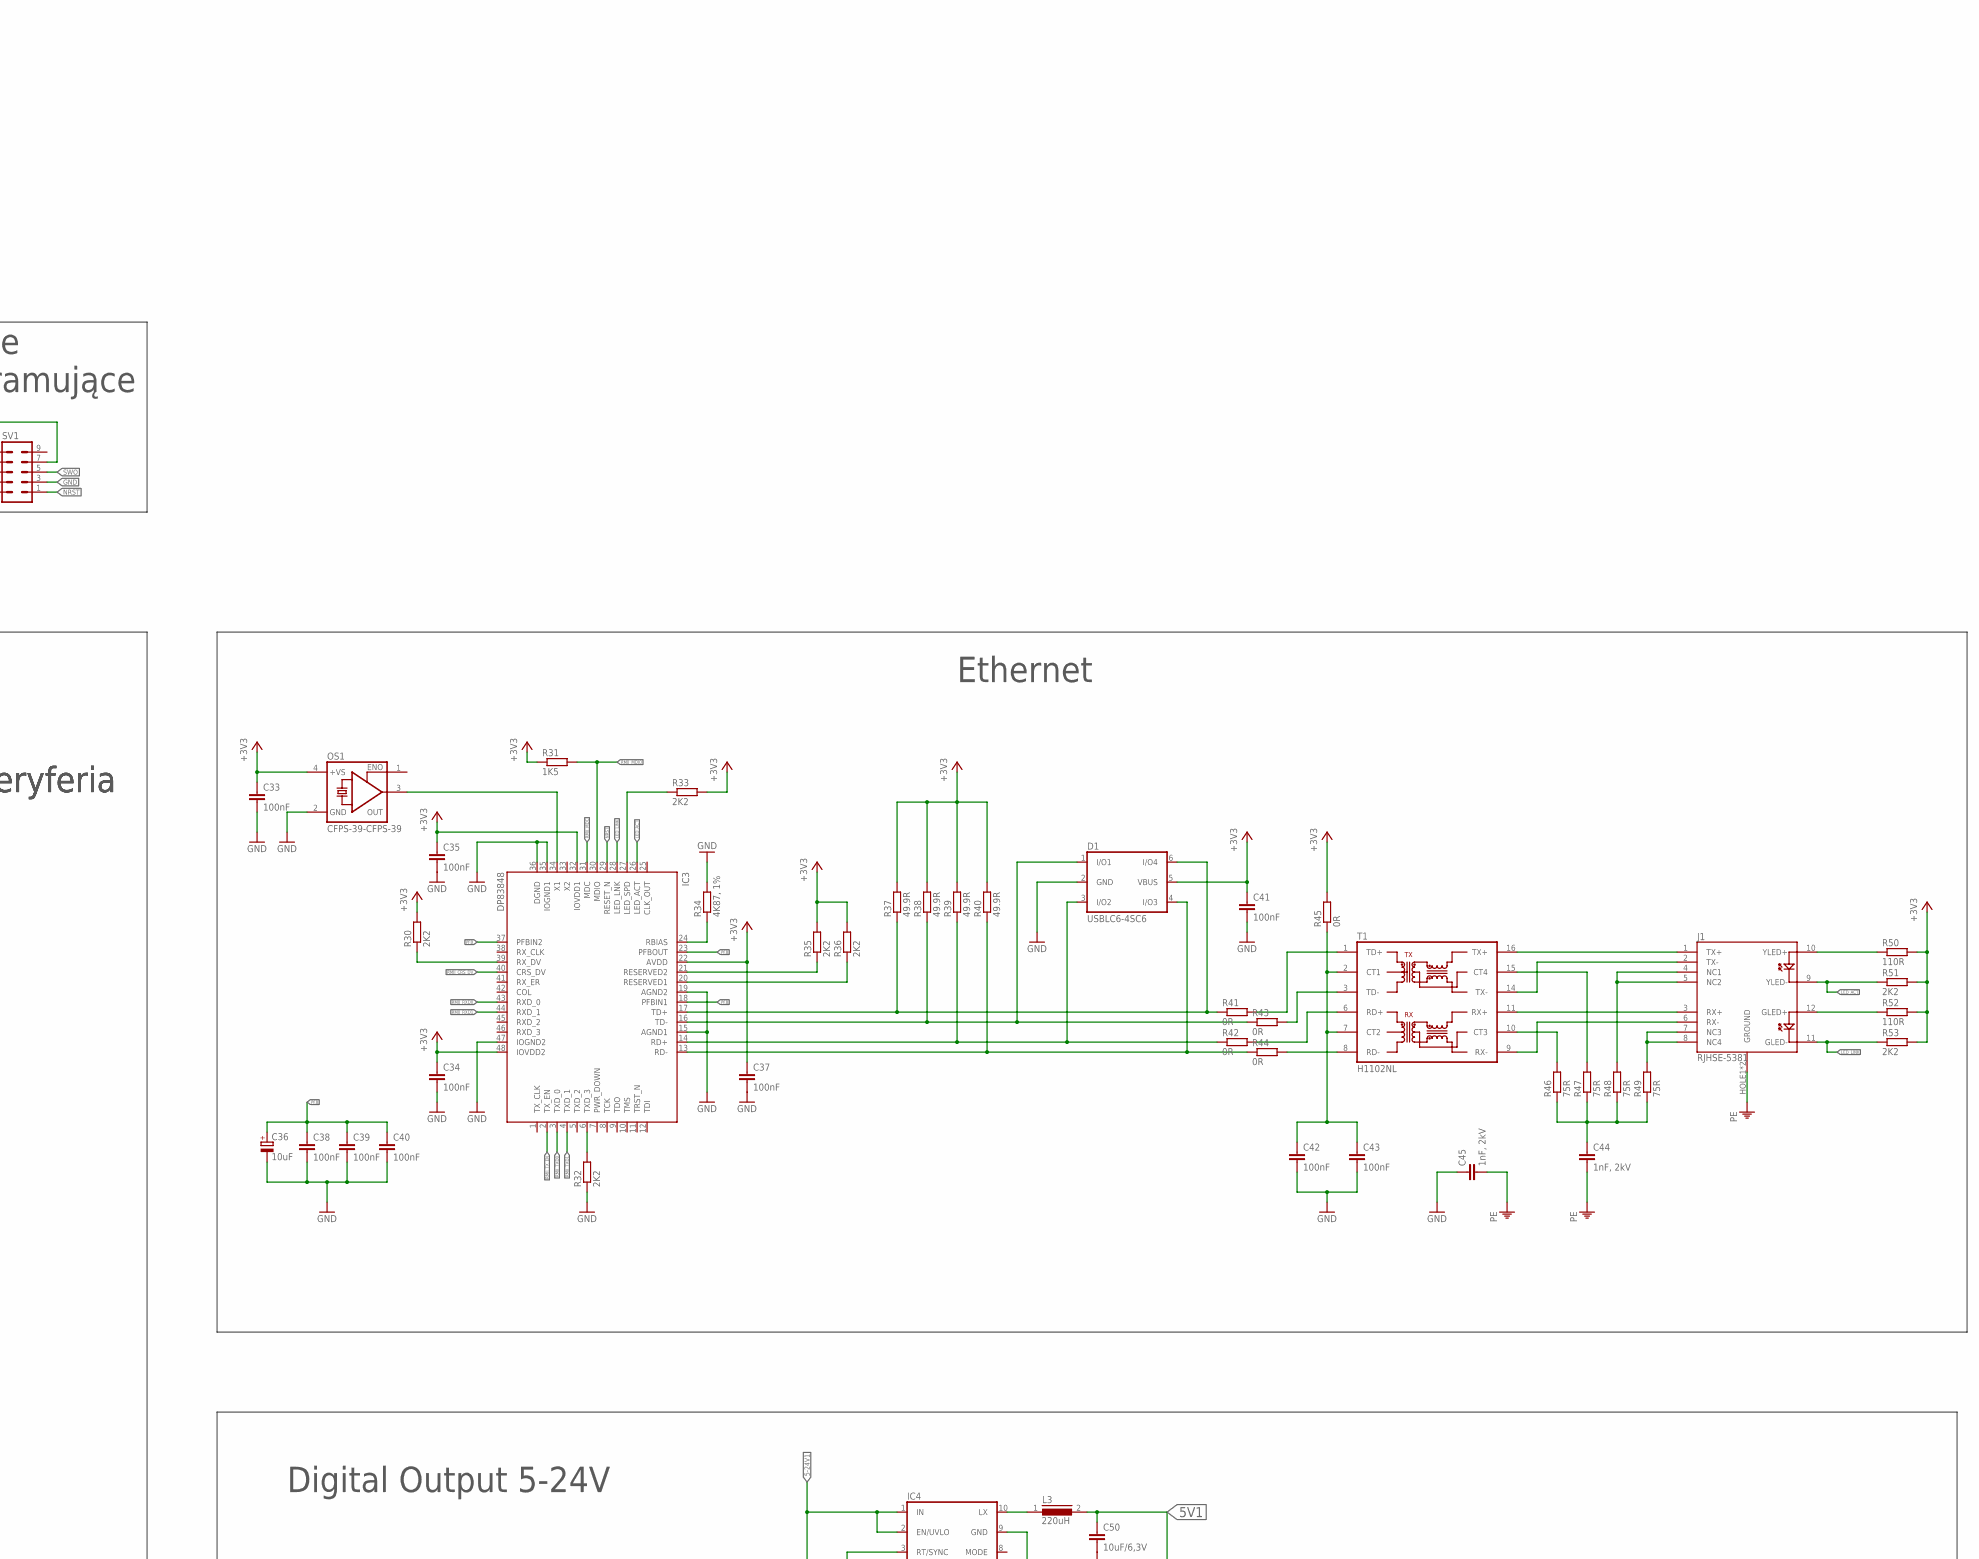
[picture p9: schematic MCU.sch, part in row 1, column 2]

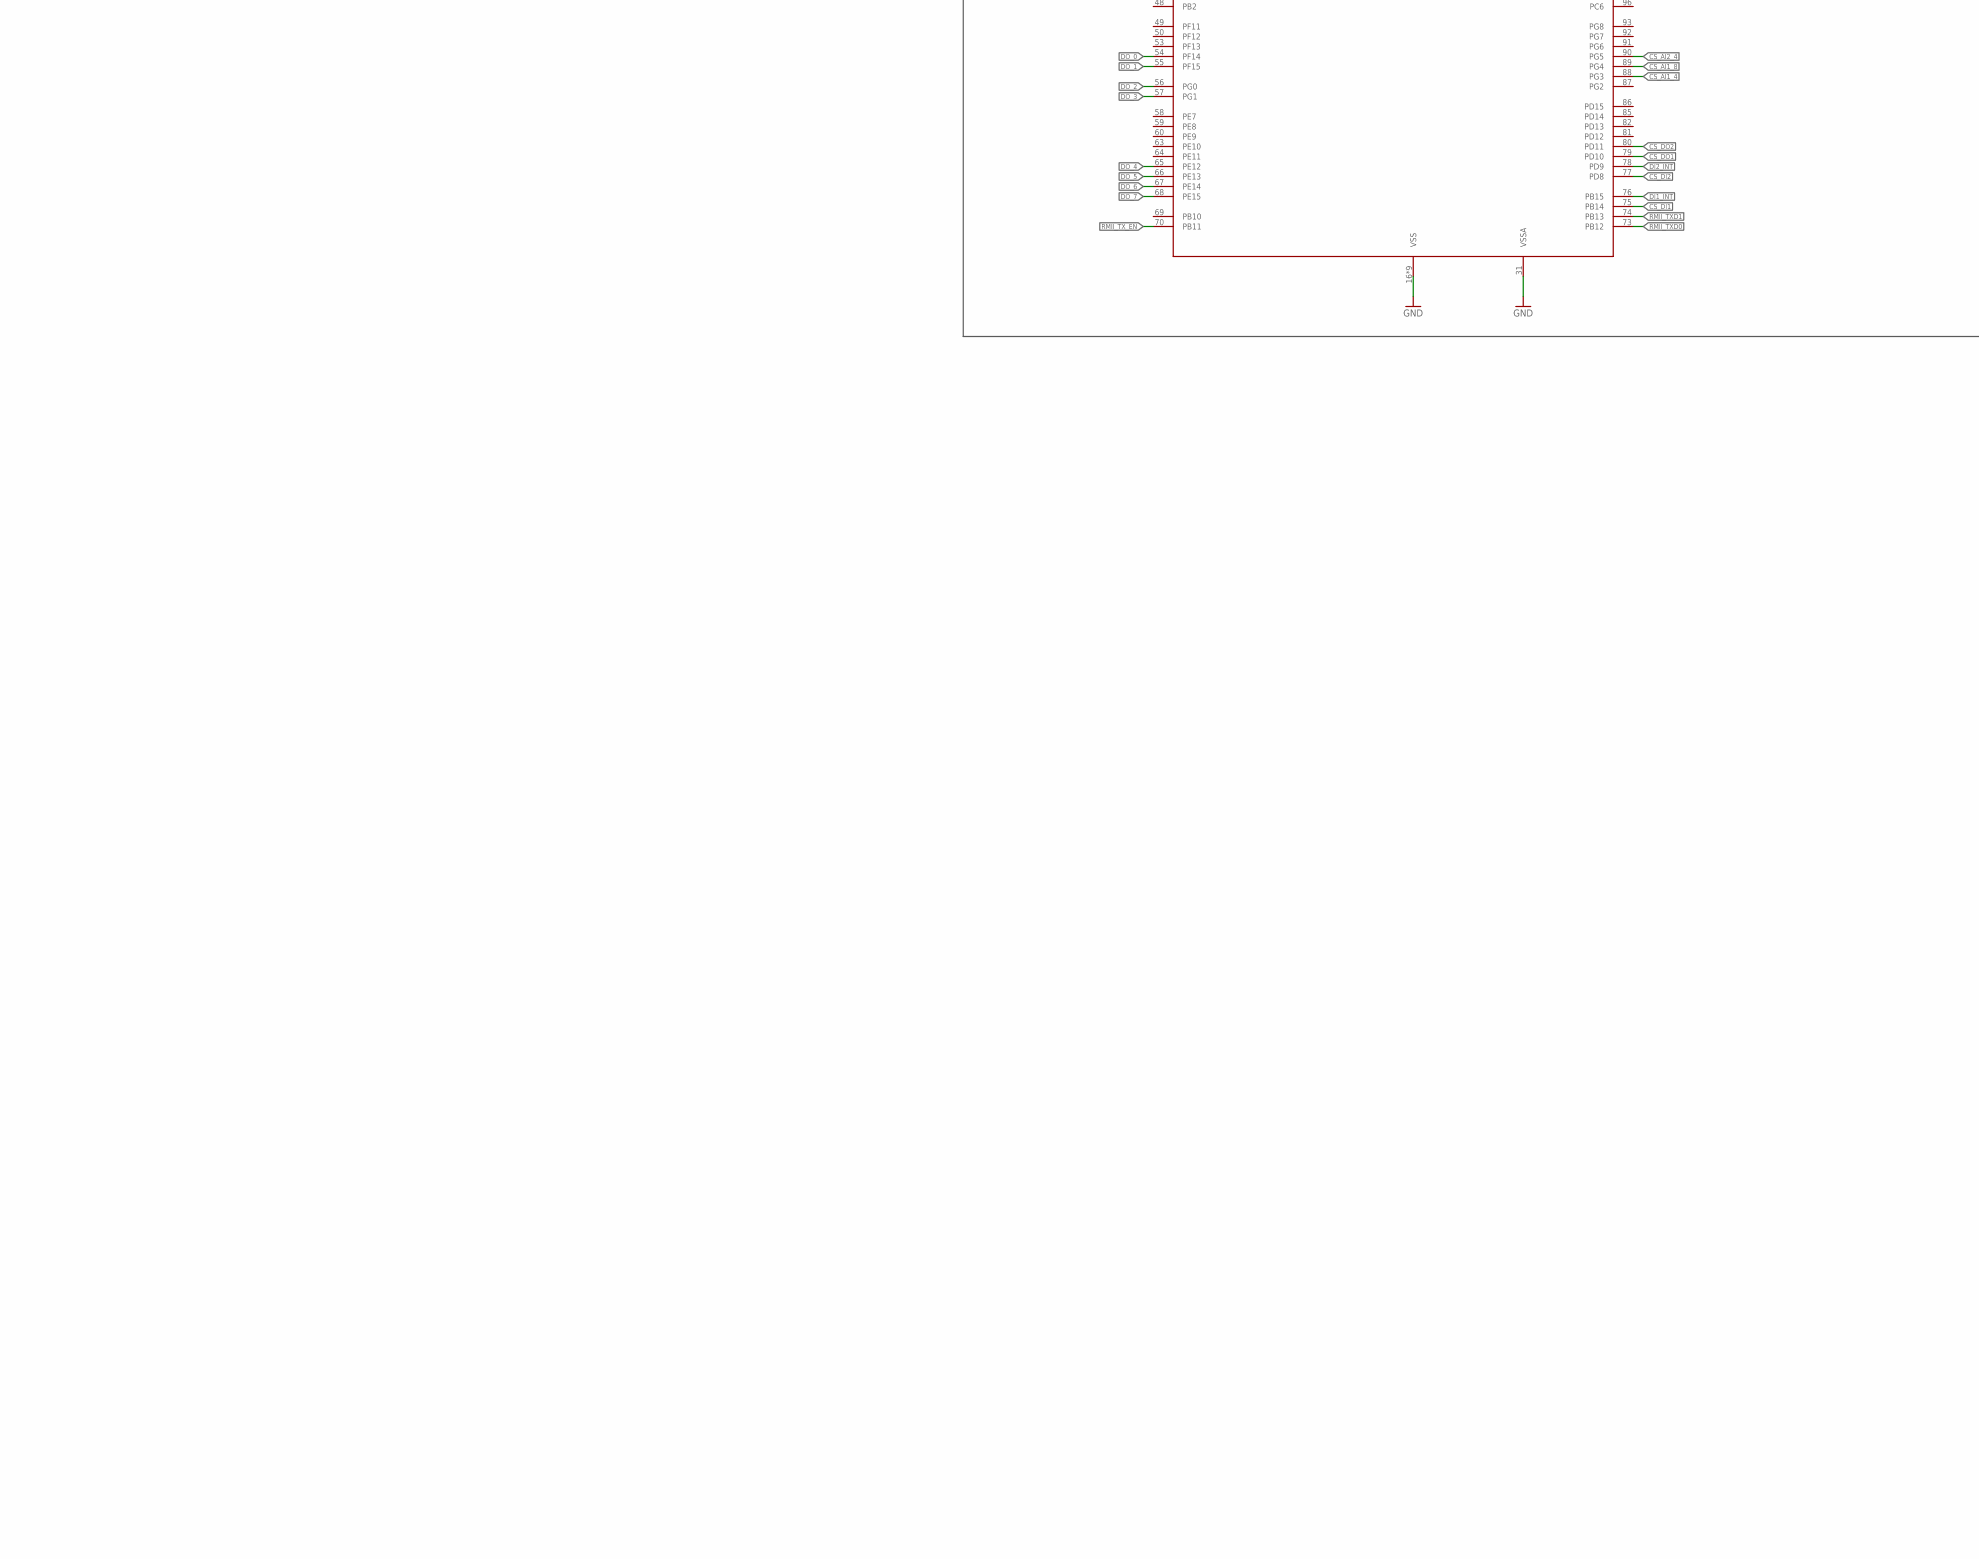
[picture p10: schematic MCU.sch, part in row 2, column 1]

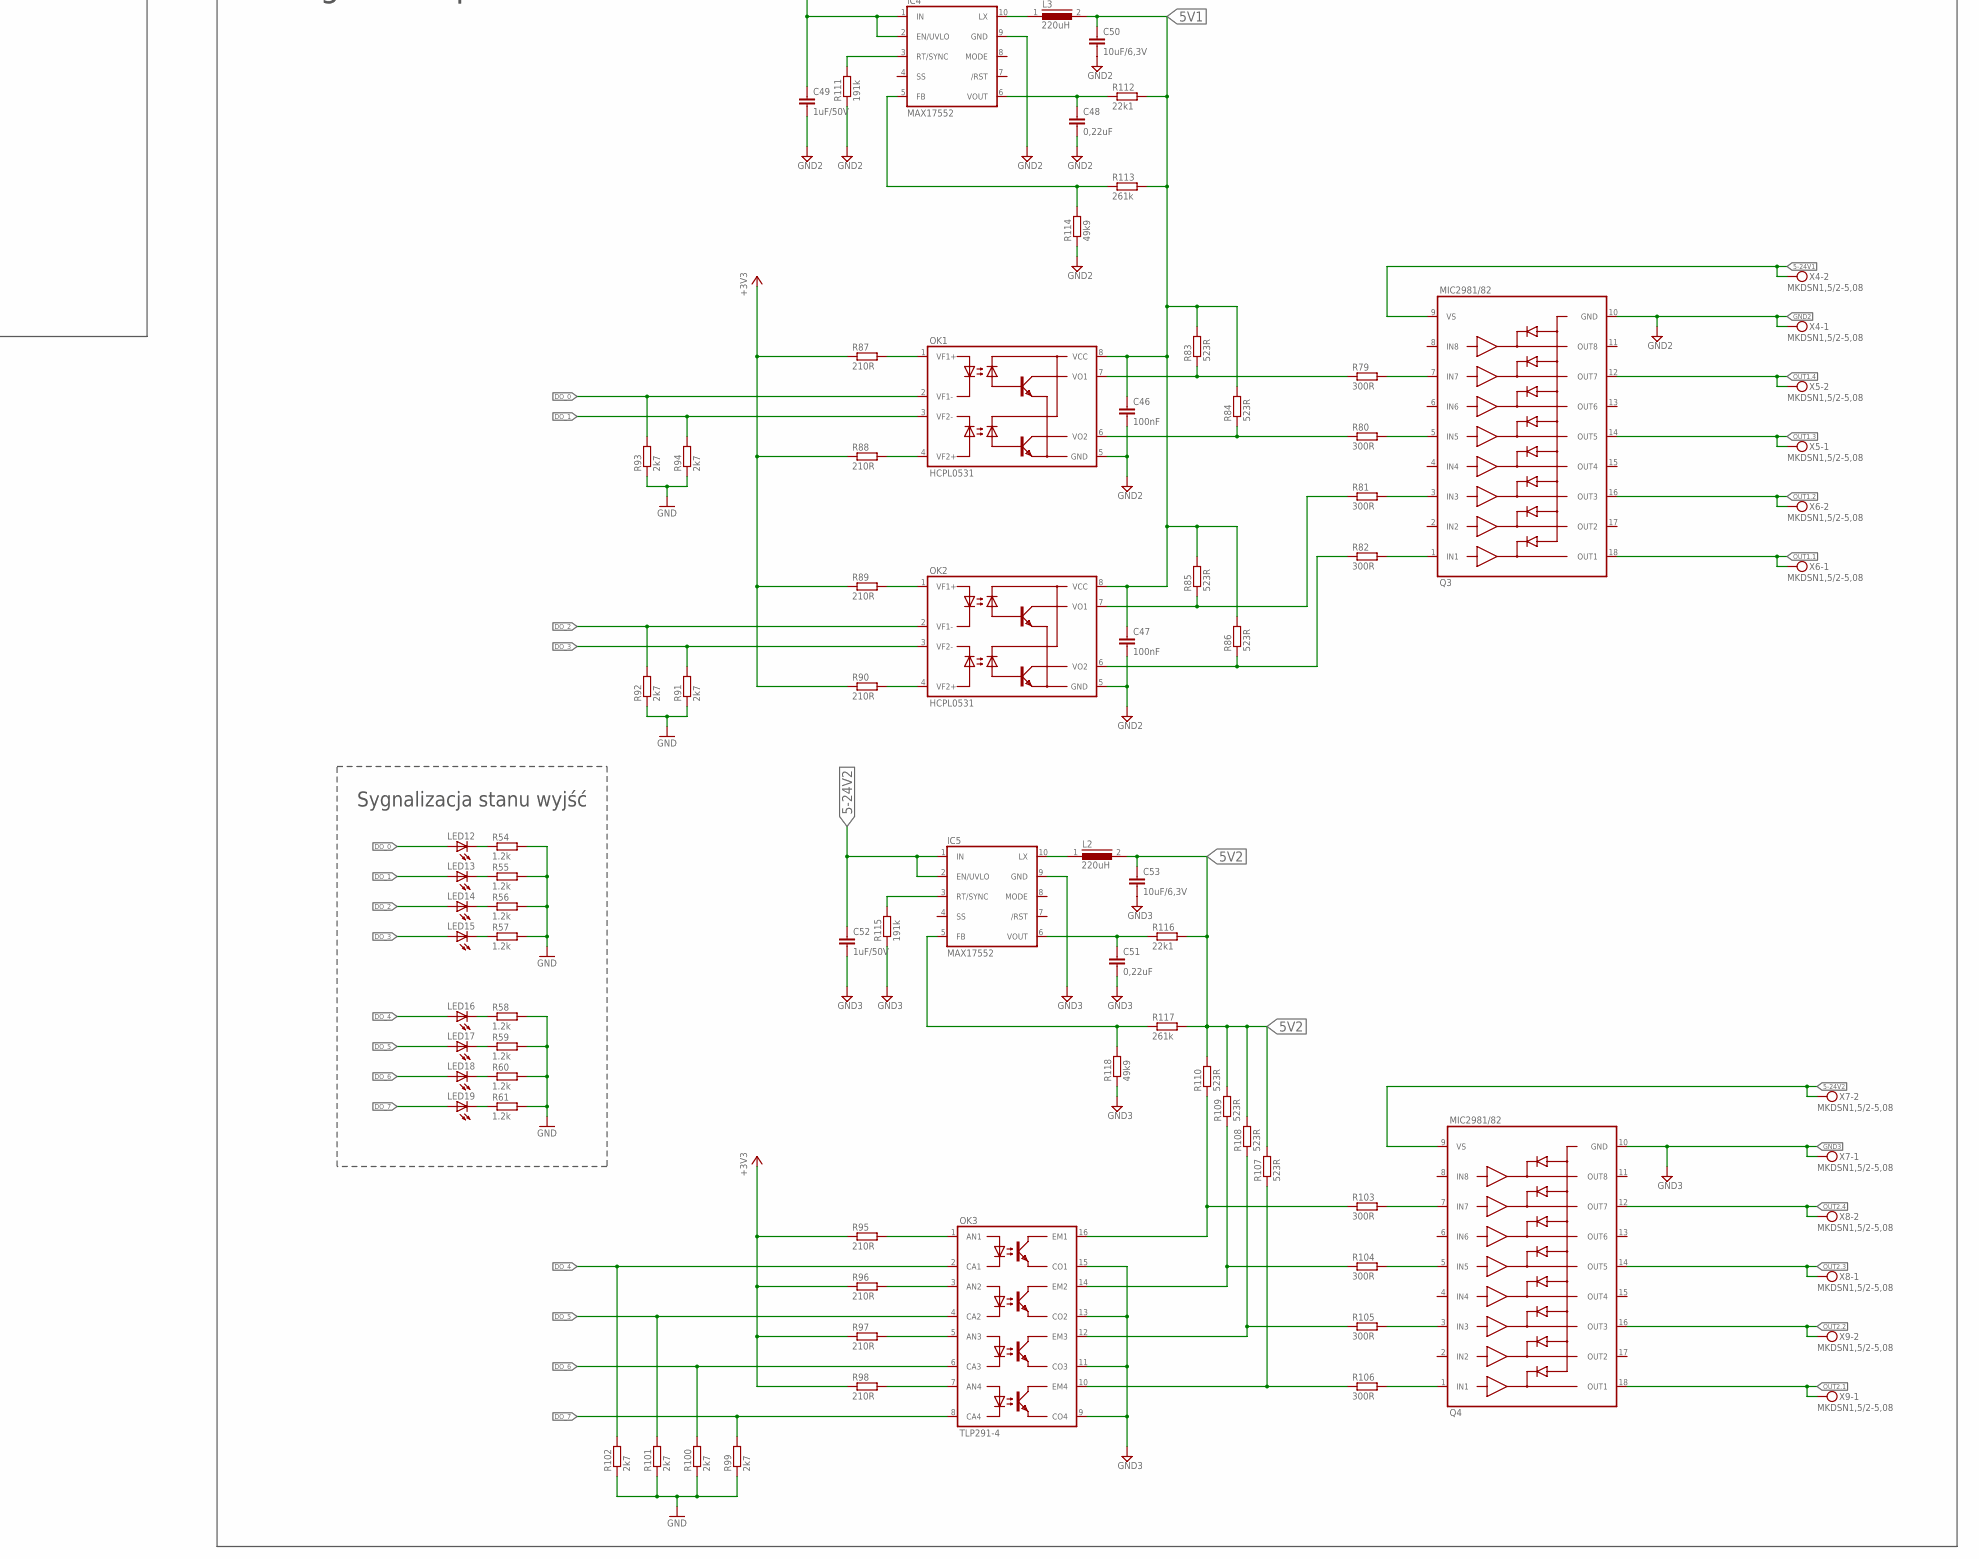
[picture p11: schematic MCU.sch, part in row 2, column 2]

Parts:
C1, C2, C3, C4, C5, C6, C7, C8: 2.2nF; C0805; MPN 06035C222JAT2A
C9, C16, C17, C18, C19, C20, C21, C22, C23, C24, C26, C28, C29, C31, C32: 100nF; C0603K; MPN 06033C104KAT2A
C10, C30: 1uF; C0603K; MPN 0603YC105KAT4A
C11, C12: 10pF; C0603K; MPN 06035A100JAT2A
C13, C14: 22pF; C0603K; MPN 06035A220JAT2A
C15: 4.7uF; C0603K; MPN 0603ZD475KAT2A
C25, C27: 2.2uF; C0603K; MPN 06036C225KAT2A
C33, C34, C35, C37, C38, C39, C40, C41, C42, C43, C46, C47: 100nF; C0603; MPN 06033C104KAT2A
C36: 10uF; SMC_A; MPN F931A106MAA
C44, C45: 1nF, 2kV; C1206; MPN VJ1206Y102MXFAT4X
C48, C51: 0,22uF; C0603; MPN 0603ZC224KAT9A
C49, C52: 1uF/50V; C1206; MPN 12065C105M4Z2A
C50, C53: 10uF/6,3V; C1206; MPN 12066G106ZAT4A
D1: USBLC6-4SC6; SOT23-6; MPN USBLC6-4SC6
G1: CH25-2032LF; MPN CH25-2032
IC1: SI8382P-IU; QSOP-20; MPN SI8382P-IU
IC2: STM32F429ZILQFP144; LQFP144; MPN STM32F429ZIT6
IC3: DP83848; LQFP48; MPN DP83848CVV/NOPB
IC4, IC5: MAX17552; TSSOP-10(10UMAX); MPN MAX17552AUB+
J1: RJHSE-5381; MAGJACK-19938; MPN RJHSE-5381
JP1: PINHD-2X6; 2X06; MPN ZL2019-40
JP2: PINHD-2X12; 2X12; MPN ZL2019-40
JP3: PINHD-1X2; 1X02; MPN DS1021-1*20SF1-5
L1: 600R; L0603; MPN MMZ1608S601ATD25
L2, L3: 220uH; SRR4528A; MPN SRR4528A-221M
LED1, LED2, LED3, LED4, LED5, LED6, LED7, LED8, LED12, LED13, LED14, LED15, LED16, LED17, LED18, LED19: LEDCHIP-LED0603; CHIP-LED0603; MPN APTD1608LCGCK
LED9, LED10: LEDCHIP-LED0603; CHIP-LED0603; MPN APTD1608LSURCK
LED11: APHF1608SEEQBDZGKC; MPN APHF1608SEEQBDZGKC
OK1, OK2: HCPL0531; SOIC08; MPN HCPL-0531-500E
OK3: TLP291-4; SO16; MPN TLP291-4(GB,E)
OS1: CFPS-39-CFPS-39; 3.4X2.7-4-PAD; MPN LFSPXO025560
Q1: 32.768kHz; CRYSTAL_3.5X1.5; MPN ECS-.327-9-34QCS-TR
Q2: CRYSTAL_SHIELD; CRYSTAL_5X3.2; MPN LFXTAL059158
Q3, Q4: MIC2981/82; SOP18; MPN MIC2981/82YWM
R1, R2, R3, R4, R5, R6, R7, R8: 6.2k; R1206; MPN RC1206JR-076K2L
R9, R10, R11, R12, R13, R14, R15, R16: 2.4k; R1206; MPN RC1206JR-072K4L
R17, R18, R19, R20, R21, R22, R23, R24, R25, R27, R28, R29, R54, R55, R56, R57, R58, R59, R60, R61: 1.2k; R0603; MPN RC0603FR-071K2L
R26: 22k; R0603; MPN AC0603FR-0722K1L
R30, R32, R33, R35, R36, R51, R53: 2K2; R0603; MPN RC0603FR-072K2P
R31: 1K5; R0603; MPN RC0603FR-071K5P
R34: 4K87, 1%; R0603; MPN AC0603FR-074K87L
R37, R38, R39, R40: 49.9R; R0603; MPN CR0603-FX-49R9GLF
R41, R42, R43, R44, R45: 0R; R0603; MPN RC0603JR-070RL
R46, R47, R48, R49: 75R; R0603; MPN RC0603JR-0775RL
R50, R52: 110R; R0603; MPN RC0603FR-07110RL
R62, R63, R64, R65, R66, R67, R68, R69, R70, R71, R72, R73, R74, R75, R76, R77, R78: 33R; R0603; MPN RC0603FR-071K2L
R79, R80, R81, R82, R103, R104, R105, R106: 300R; R0603; MPN AC0603FR-07300RL
R83, R84, R85, R86, R107, R108, R109, R110: 523R; R0603; MPN RC0603FR-07523RL
R87, R88, R89, R90, R95, R96, R97, R98: 210R; R0603; MPN CR0603-FX-2100ELF
R91, R92, R93, R94, R99, R100, R101, R102: 2k7; R0603; MPN RC0603JR-072K7L
R111, R115: 191k; R0603; MPN AC0603FR-07191KL
R112, R116: 22k1; R0603; MPN AC0603FR-0722K1L
R113, R117: 261k; R0603; MPN CR0603-FX-2613ELF
R114, R118: 49k9; R0603; MPN CRCW060349K9FKEB
S1: DTSM-6; MPN DTSM-63N-V-B
SV1: ML10; MPN 61201021621
T1: H1102NL; HXXXX; MPN H1102NL
X1, X2, X3, X4, X5, X6, X7, X8, X9, X10, X11: MKDSN1,5/2-5,08; MPN TB-5.08-P-2P/BL

Connections:
5-24V1: C49.1, IC4.1 (IN), IC4.2 (EN/UVLO), Q3.9 (VS), X4.2
5-24V2: C52.1, IC5.1 (IN), IC5.2 (EN/UVLO), Q4.9 (VS), X7.2
5V1: C46.1, C47.1, C50.1, L3.2, OK1.8 (VCC), OK2.8 (VCC), R83.2, R84.2, R85.2, R86.2, R112.2, R113.2
5V2: C53.1, L2.2, R107.2, R108.2, R109.2, R110.2, R116.2, R117.2
+3V3: C9.1, C10.1, C15.1, C16.1, C17.1, C18.1, C19.1, C20.1, C22.1, C23.1, C24.1, C26.1, C28.1, C29.1, C31.1, C33.1, C34.1, C35.1, C37.1, C41.1, D1.5 (VBUS), IC1.16 (VDD), IC2.17 (VDD), IC2.30 (VDD), IC2.39 (VDD), IC2.52 (VDD), IC2.62 (VDD), IC2.72 (VDD), IC2.84 (VDD), IC2.95 (VDD), IC2.108 (VDD), IC2.121 (VDD), IC2.131 (VDD), IC2.143 (PDR_ON), IC2.144 (VDD), IC3.22 (AVDD), IC3.32 (IOVDD1), IC3.48 (IOVDD2), JP1.1, JP1.2, JP3.1, L1.2, LED11.1 (A), OS1.4 (VDD), R25.1, R30.2, R31.1, R33.2, R35.2, R36.2, R37.2, R38.2, R39.2, R40.2, R45.2, R50.2, R51.2, R52.2, R53.2, R87.1, R88.1, R89.1, R90.1, R95.1, R96.1, R97.1, R98.1
+24V: JP1.11, JP1.12, R26.1
COM: C1.2, C2.2, C3.2, C4.2, C5.2, C6.2, C7.2, C8.2, IC1.5 (COM), IC1.6 (COM), R9.1, R10.1, R11.1, R12.1, R13.1, R14.1, R15.1, R16.1, X1.1, X11.2
CS_AI1_4: IC2.88 (PG3), R67.1
CS_AI1_8: IC2.89 (PG4), R75.2
CS_AI2_4: IC2.90 (PG5), R74.2
CS_AI2_8: IC2.98 (PC8), R66.1
CS_AO1_4: IC2.99 (PC9), R73.2
CS_AO1_8: IC2.100 (PA8), R65.1
CS_AO2_4: IC2.102 (PA10), R72.2
CS_AO2_8: IC2.101 (PA9), R64.1
CS_DI1: IC2.75 (PB14), R70.1
CS_DI2: IC2.77 (PD8), R77.2
CS_DO1: IC2.79 (PD10), R76.2
CS_DO2: IC2.80 (PD11), R68.1
DI1_INT: IC2.76 (PB15), R78.2
DI2_INT: IC2.78 (PD9), R69.1
DI_0: IC1.20 (B1/BH1), IC2.134 (PB4), LED1.A
DI_1: IC1.19 (B2/BH2), IC2.135 (PB5), LED2.A
DI_2: IC1.18 (B3/BH3), IC2.136 (PB6), LED3.A
DI_3: IC1.17 (B4/BH4), IC2.137 (PB7), LED4.A
DI_4: IC1.14 (B5/BH5), IC2.139 (PB8), LED5.A
DI_5: IC1.13 (B6/BH6), IC2.140 (PB9), LED6.A
DI_6: IC1.12 (B7/BH7), IC2.141 (PE0), LED7.A
DI_7: IC1.11 (B8/BH8), IC2.142 (PE1), LED8.A
DMX_DIR: IC2.20 (PF8), JP1.5
DMX_RX: IC2.18 (PF6), JP1.8
DMX_TX: IC2.19 (PF7), JP1.7
DO_0: IC2.54 (PF14), LED12.A, OK1.2 (VF1-), R93.2
DO_1: IC2.55 (PF15), LED13.A, OK1.3 (VF2-), R94.2
DO_2: IC2.56 (PG0), LED14.A, OK2.2 (VF1-), R92.2
DO_3: IC2.57 (PG1), LED15.A, OK2.3 (VF2-), R91.2
DO_4: IC2.65 (PE12), LED16.A, OK3.2 (CA1), R102.2
DO_5: IC2.66 (PE13), LED17.A, OK3.4 (CA2), R101.2
DO_6: IC2.67 (PE14), LED18.A, OK3.6 (CA3), R100.2
DO_7: IC2.68 (PE15), LED19.A, OK3.8 (CA4), R99.2
GND: C9.2, C10.2, C11.2, C12.2, C13.2, C14.2, C15.2, C16.2, C17.2, C18.2, C19.2, C20.2, C21.2, C22.2, C23.2, C24.2, C25.1, C26.2, C27.1, C28.2, C29.2, C30.2, C31.2, C32.2, C33.2, C34.2, C35.2, C36.-, C37.2, C38.2, C39.2, C40.2, C41.2, C42.2, C43.2, C45.1, D1.2 (GND), G1.-, IC1.15 (GND), IC2.16 (VSS), IC2.31 (VSSA), IC2.38 (VSS), IC2.51 (VSS), IC2.61 (VSS), IC2.83 (VSS), IC2.94 (VSS), IC2.107 (VSS), IC2.120 (VSS), IC2.130 (VSS), IC3.15 (AGND1), IC3.19 (AGND2), IC3.35 (IOGND1), IC3.36 (DGND), IC3.47 (IOGND2), JP1.3, JP1.4, JP1.6, JP1.9, JP1.10, JP2.4, JP2.5, JP2.6, JP2.10, JP2.13, JP2.18, JP2.21, LED9.C, LED10.C, OS1.2 (VSS), Q2.2, Q2.4, R17.2, R18.2, R19.2, R20.2, R21.2, R22.2, R23.2, R24.2, R32.1, R34.2, R54.2, R55.2, R56.2, R57.2, R58.2, R59.2, R60.2, R61.2, R91.1, R92.1, R93.1, R94.1, R99.1, R100.1, R101.1, R102.1, S1.1, S1.2, SV1.3, SV1.4
GND2: C46.2, C47.2, C48.2, C49.2, C50.2, IC4.9 (GND), OK1.5 (GND), OK2.5 (GND), Q3.10 (GND), R111.1, R114.1, X4.1
GND3: C51.2, C52.2, C53.2, IC5.9 (GND), OK3.9 (CO4), OK3.11 (CO3), OK3.13 (CO2), OK3.15 (CO1), Q4.10 (GND), R115.1, R118.1, X7.1
LED_ACT: IC3.26 (LED_ACT), J1.9 (YLED-), R51.1
LED_BLUE: IC2.2 (PE3), R28.2
LED_GREEN: IC2.3 (PE4), R29.2
LED_LINK: IC3.28 (LED_LNK), J1.11 (GLED-), R53.1
LED_RED: IC2.1 (PE2), R27.2
unnamed: LED11.2 (CRED), R27.1
unnamed: C25.2, IC2.71 (VCAP1)
unnamed: C27.2, IC2.106 (VCAP2)
unnamed: C11.1, IC2.8 (PC14), Q1.1
unnamed: C12.1, IC2.9 (PC15), Q1.2
unnamed: LED12.C, R54.1
unnamed: C13.1, IC2.23 (PH0), Q2.1
unnamed: C14.1, IC2.24 (PH1), Q2.3
unnamed: C1.1, IC1.1 (A1/AH1), R1.2, R9.2
unnamed: LED11.3 (CBLUE), R28.1
unnamed: LED1.C, R17.1
unnamed: C2.1, IC1.2 (A2/AH2), R2.2, R10.2
unnamed: LED2.C, R18.1
unnamed: LED3.C, R19.1
unnamed: R1.1, X11.1
unnamed: LED11.4 (CGREEN), R29.1
unnamed: LED4.C, R20.1
unnamed: R2.1, X10.2
unnamed: C3.1, IC1.3 (A3/AH3), R3.2, R11.2
unnamed: R3.1, X10.1
unnamed: C4.1, IC1.4 (A4/AH4), R4.2, R12.2
unnamed: R4.1, X3.2
unnamed: C5.1, IC1.7 (A5/AH5), R5.2, R13.2
unnamed: R5.1, X3.1
unnamed: C6.1, IC1.8 (A6/AH6), R6.2, R14.2
unnamed: R6.1, X2.2
unnamed: C7.1, IC1.9 (A7/AH7), R7.2, R15.2
unnamed: R7.1, X2.1
unnamed: C8.1, IC1.10 (A8/AH8), R8.2, R16.2
unnamed: R8.1, X1.2
unnamed: LED10.A, R26.2
unnamed: LED5.C, R21.1
unnamed: LED6.C, R22.1
unnamed: LED7.C, R23.1
unnamed: LED8.C, R24.1
unnamed: LED13.C, R55.1
unnamed: LED14.C, R56.1
unnamed: LED15.C, R57.1
unnamed: J1.4 (NC1), J1.5 (NC2), R48.2
unnamed: J1.7 (NC3), J1.8 (NC4), R49.2
unnamed: R47.2, T1.15 (CT4)
unnamed: LED9.A, R25.2
unnamed: R46.2, T1.10 (CT3)
unnamed: C44.1, R46.1, R47.1, R48.1, R49.1
unnamed: J1.12 (GLED+), R52.1
unnamed: J1.10 (YLED+), R50.1
unnamed: LED16.C, R58.1
unnamed: LED17.C, R59.1
unnamed: LED18.C, R60.1
unnamed: LED19.C, R61.1
unnamed: C42.1, C43.1, R45.1, T1.2 (CT1), T1.7 (CT2)
unnamed: IC3.21 (RESERVED2), R35.1
unnamed: IC3.20 (RESERVED1), R36.1
unnamed: IC3.24 (RBIAS), R34.1
unnamed: R41.2, T1.1 (TD+)
unnamed: R43.2, T1.3 (TD-)
unnamed: R42.2, T1.6 (RD+)
unnamed: R44.2, T1.8 (RD-)
unnamed: IC3.34 (X1), OS1.3 (OUT)
unnamed: IC3.27 (LED_SPD), R33.1
unnamed: IC3.39 (RX_DV), R30.1
unnamed: IC3.6 (TXD_3), R32.2
unnamed: JP3.2, SV1.7, SV1.8
unnamed: JP2.2, R71.1
unnamed: JP2.8, R72.1
unnamed: JP2.12, R73.1
unnamed: JP2.14, R74.1
unnamed: JP2.16, R75.1
unnamed: JP2.20, R76.1
unnamed: JP2.22, R77.1
unnamed: JP2.3, R63.2
unnamed: JP2.1, R62.2
unnamed: JP2.7, R64.2
unnamed: JP2.9, R65.2
unnamed: JP2.11, R66.2
unnamed: JP2.15, R67.2
unnamed: JP2.17, R68.2
unnamed: JP2.19, R69.2
unnamed: JP2.23, R70.2
unnamed: JP2.24, R78.1
unnamed: OK1.7 (VO1), R79.1, R83.1
unnamed: Q3.7 (IN7), R79.2
unnamed: OK1.6 (VO2), R80.1, R84.1
unnamed: OK2.7 (VO1), R81.1, R85.1
unnamed: OK2.6 (VO2), R82.1, R86.1
unnamed: Q3.5 (IN5), R80.2
unnamed: Q3.3 (IN3), R81.2
unnamed: Q3.1 (IN1), R82.2
unnamed: OK1.1 (VF1+), R87.2
unnamed: OK1.4 (VF2+), R88.2
unnamed: OK2.1 (VF1+), R89.2
unnamed: OK2.4 (VF2+), R90.2
unnamed: OK3.1 (AN1), R95.2
unnamed: OK3.3 (AN2), R96.2
unnamed: OK3.5 (AN3), R97.2
unnamed: OK3.7 (AN4), R98.2
unnamed: Q4.7 (IN7), R103.2
unnamed: Q4.5 (IN5), R104.2
unnamed: Q4.3 (IN3), R105.2
unnamed: Q4.1 (IN1), R106.2
unnamed: OK3.12 (EM3), R105.1, R108.1
unnamed: OK3.14 (EM2), R104.1, R109.1
unnamed: OK3.16 (EM1), R103.1, R110.1
unnamed: OK3.10 (EM4), R106.1, R107.1
unnamed: IC4.3 (RT/SYNC), R111.2
unnamed: IC4.10 (LX), L3.1
unnamed: IC4.5 (FB), R113.1, R114.2
unnamed: C48.1, IC4.6 (VOUT), R112.1
unnamed: IC5.3 (RT/SYNC), R115.2
unnamed: IC5.10 (LX), L2.1
unnamed: IC5.5 (FB), R117.1, R118.2
unnamed: C51.1, IC5.6 (VOUT), R116.1
NRST: C21.1, IC2.25 (NRST), IC3.29 (RESET_N), S1.3, S1.4, SV1.1
OUT1.1: Q3.18 (OUT1), X6.1
OUT1.2: Q3.16 (OUT3), X6.2
OUT1.3: Q3.14 (OUT5), X5.1
OUT1.4: Q3.12 (OUT7), X5.2
OUT2.1: Q4.18 (OUT1), X9.1
OUT2.2: Q4.16 (OUT3), X9.2
OUT2.3: Q4.14 (OUT5), X8.1
OUT2.4: Q4.12 (OUT7), X8.2
PE: C44.2, C45.2, J1.HOLE1 (GROUND), J1.HOLE2 (GROUND)
PFB: C36.+, C38.1, C39.1, C40.1, IC3.18 (PFBIN1), IC3.23 (PFBOUT), IC3.37 (PFBIN2)
RD_N: D1.4 (I/O3), IC3.13 (RD-), R40.1, R44.1
RD_P: D1.3 (I/O2), IC3.14 (RD+), R39.1, R42.1
RMII_CRS_DV: IC2.43 (PA7), IC3.40 (CRS_DV)
RMII_MDC: IC2.27 (PC1), IC3.31 (MDC)
RMII_MDIO: IC2.36 (PA2), IC3.30 (MDIO), R31.2
RMII_RXD0: IC2.44 (PC4), IC3.43 (RXD_0)
RMII_RXD1: IC2.45 (PC5), IC3.44 (RXD_1)
RMII_TXD0: IC2.73 (PB12), IC3.3 (TXD_0)
RMII_TXD1: IC2.74 (PB13), IC3.4 (TXD_1)
RMII_TX_EN: IC2.70 (PB11), IC3.2 (TX_EN)
RX_N: J1.6 (RX-), T1.9 (RX-)
RX_P: J1.3 (RX+), T1.11 (RX+)
SPI_MISO: IC2.112 (PC11), R71.2
SPI_MOSI: IC2.113 (PC12), R62.1
SPI_SCK: IC2.111 (PC10), R63.1
SWCLK: IC2.109 (PA14), SV1.6
SWDIO: IC2.105 (PA13), SV1.2
SWO: IC2.133 (PB3), SV1.5
TD_N: D1.1 (I/O1), IC3.16 (TD-), R38.1, R43.1
TD_P: D1.6 (I/O4), IC3.17 (TD+), R37.1, R41.1
TX_N: J1.2 (TX-), T1.14 (TX-)
TX_P: J1.1 (TX+), T1.16 (TX+)
VBAT: C30.1, G1.+, IC2.6 (VBAT)
VDDA: C32.1, IC2.32 (VREF+), IC2.33 (VDDA), L1.1

Notes on the sheet:
Mikrokontroler i peryferia
Sygnalizacja zasilania + statusu
1mA @3V3
Digital Input 24V
Szybkie wejścia HSC
1mA @24V
Do zweryfikowania jasność świecenia (na etapie testowania prototypu)
Ethernet
Opcjonalnie, kondensatory używane w przypadku HSC - do modyfikacji wraz z dopasowaną wersją izolatora wejść
Złącze zasilające + DMX
Decaps
Złącze wyjściowe na moduły SPI + CS
Złącze programujące
Digital Output 5-24V
Do zweryfikowania wartości rezystorów - opcjonalnie podłączenie kondensatorów. "Resistor array" zamiast pojedynczych
Sygnalizacja stanu wyjść

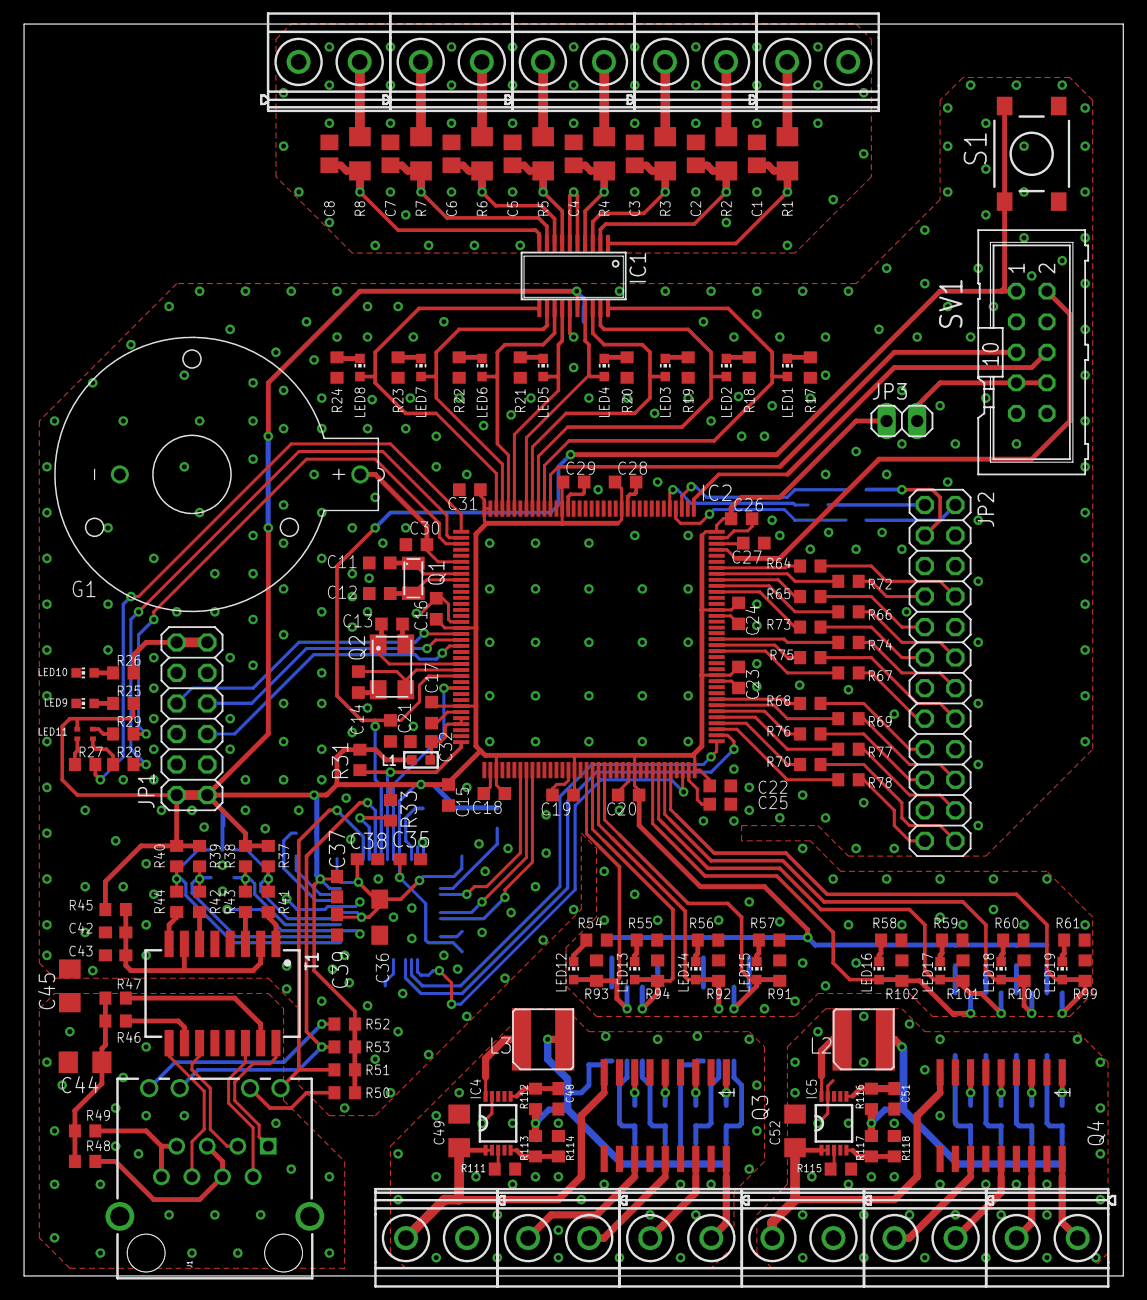
[picture p12: board MCU.brd from above]

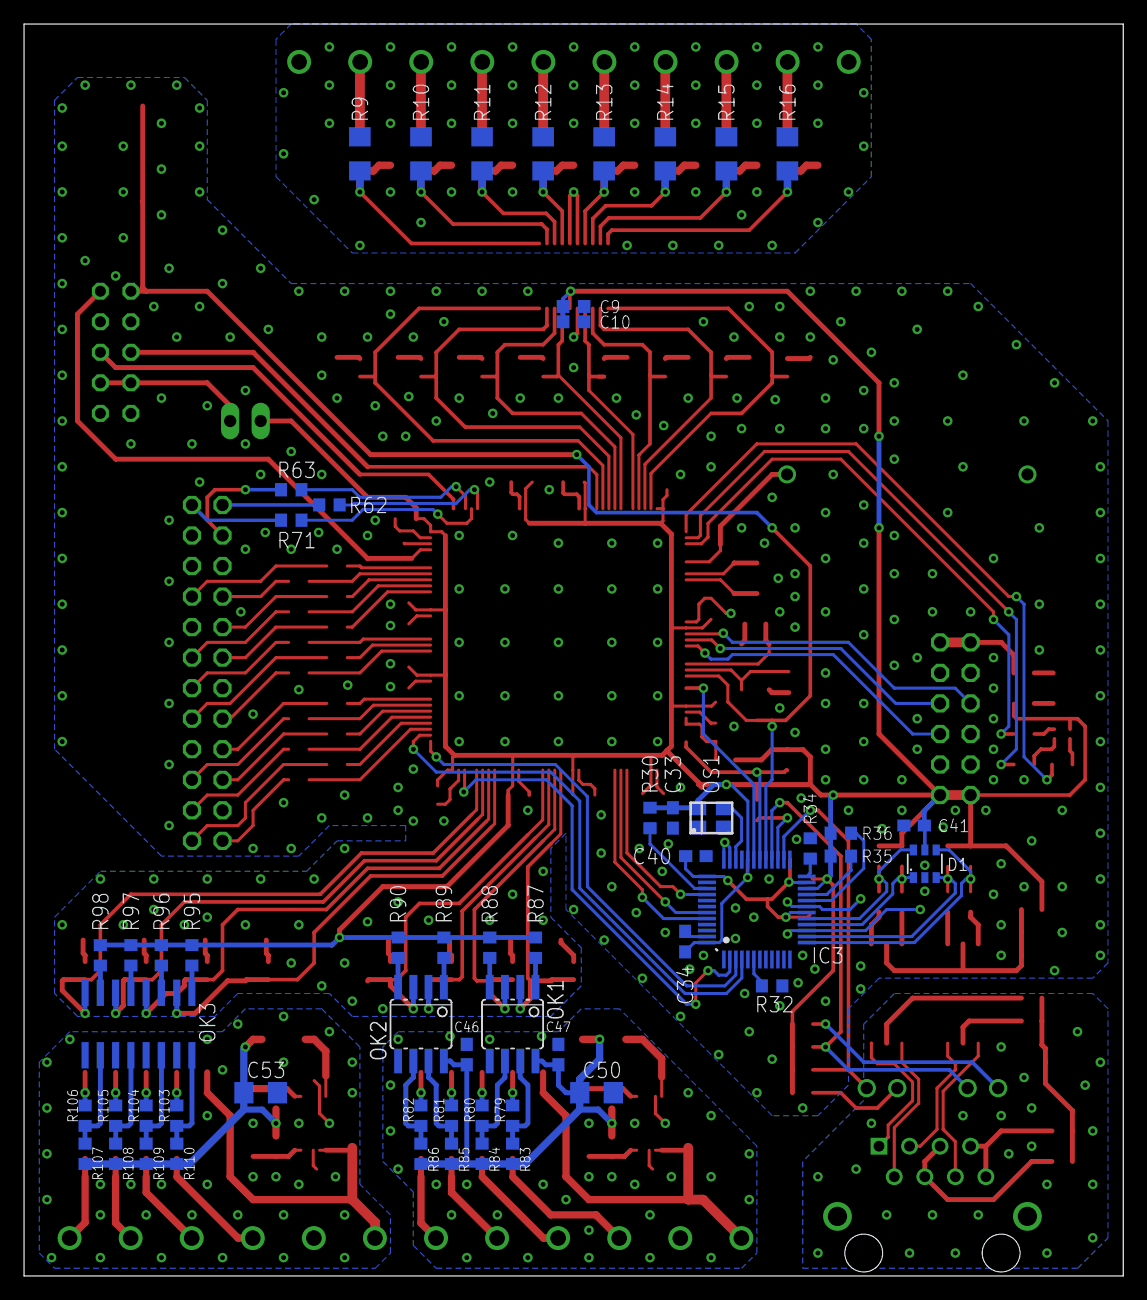
[picture p13: board MCU.brd from below]

Board: 2 copper layers, 91.4 x 104.1 mm, 226 parts (56 on the bottom side), 195 nets.
