fx-tronik/svs-controller/(notices)

Notices in the files:
parts and their libraries:
rc-master-smd: Copyright (C) 2007, Bob Starr
